isc-fs/IFS09-TE/hardware/docs/images/pcb_layout_2d.png

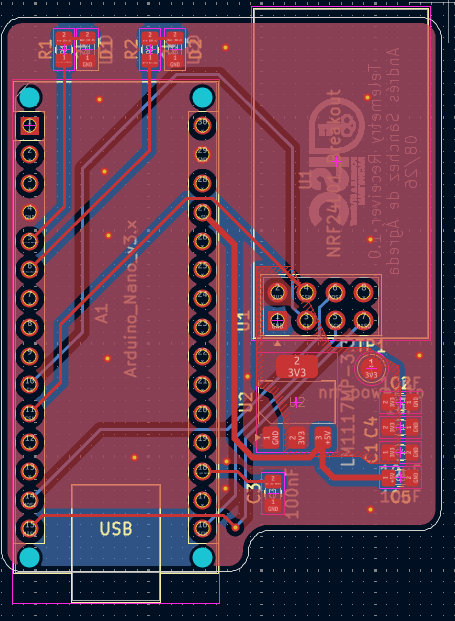
hardware/docs/images/pcb_layout_2d.png
