isc-fs/IFS09-TE/hardware/docs/images/pcb_render_3d.png

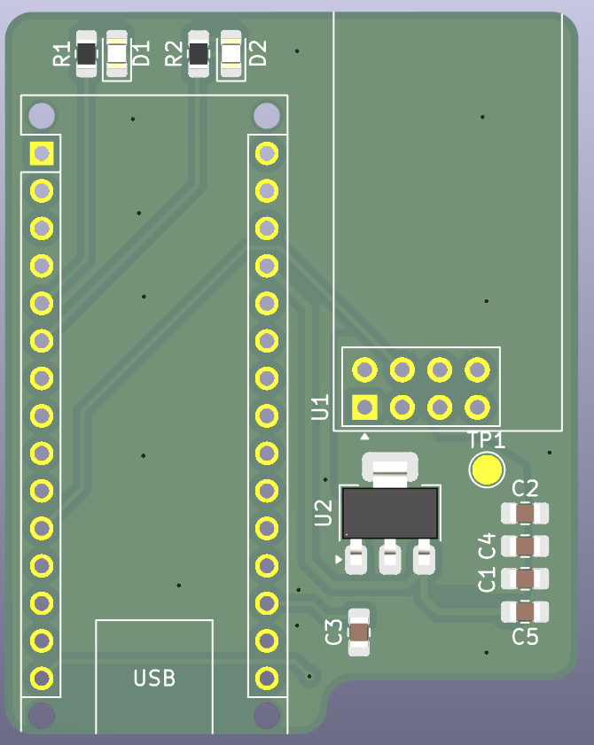
hardware/docs/images/pcb_render_3d.png
