isc-fs/IFS09-TE/hardware/docs/images/rf_nano_pinout.png

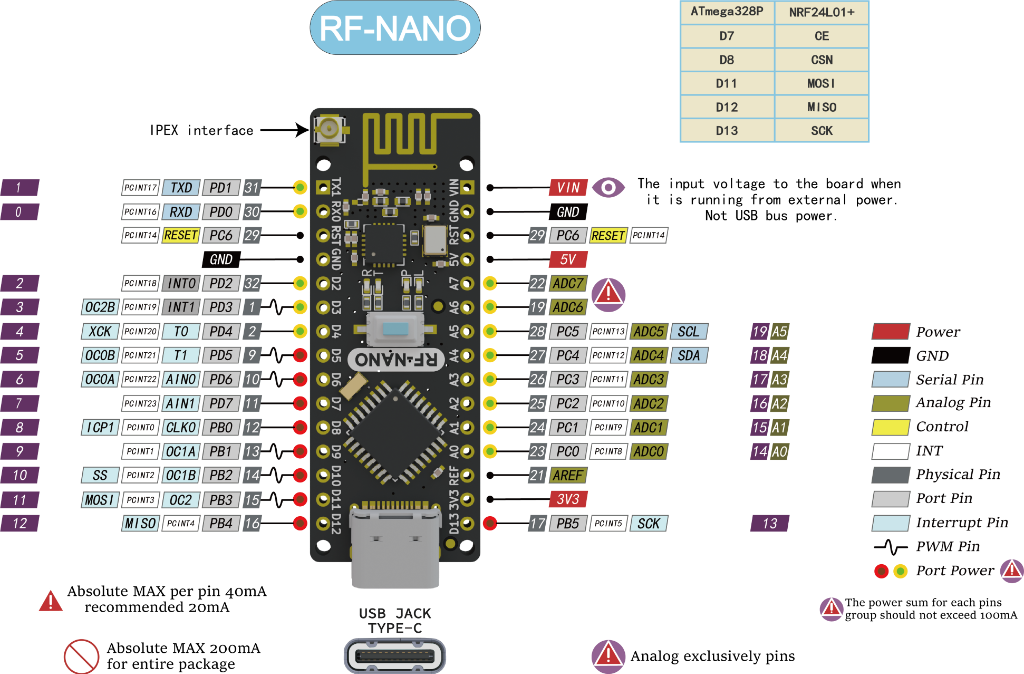
hardware/docs/images/rf_nano_pinout.png
