isc-fs/IFS09-TE/hardware/docs/images/schematic_v2.png

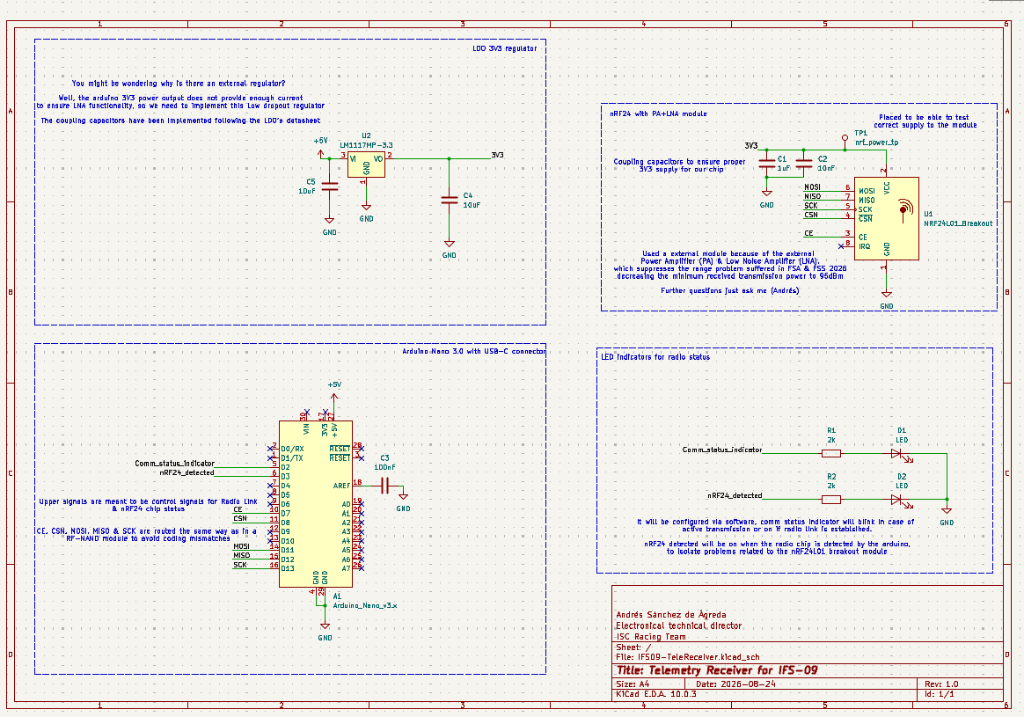
hardware/docs/images/schematic_v2.png
