isc-fs/IFS09-TE/isc_realtime_26/ISC_Telemetry_Guide.docx

ISC Telemetry Operational Guide

Hardware Setup, ISCmetrics Suite & Marple Cloud Data Platform

1. Physical Hardware Setup

1.1 Car Side (Transmitter / ECU)

• Antenna Positioning: Mount vertically on the roll hoop or shark fin with an insulating spacer. Maintain at least 3.5 cm (λ/4) clearance from carbon fiber panels to avoid signal absorption.
• RF Cabling: Use low-loss RG-316 or RG-142 coaxial cable with SMA connectors (< 50 cm). Route away from high-voltage (HV) lines and inverter phase cables.
• Decoupling Capacitor: High-power PA modules (e.g. E01-ML01DP5) draw up to 150 mA peak during transmit bursts. Solder a 10–100 µF electrolytic in parallel with a 100 nF ceramic capacitor directly across the module's VCC (3.3V) and GND pins.

1.2 Pitwall Side (USB Receiver Ground Station)

• Hardware: Arduino Nano / USB dongle connected to nRF24L01+ + PA/LNA module over SPI, communicating via USB-Serial at 115200 baud.
• Mast Elevation: Mount the high-gain antenna (+9 to +14 dBi) on a tripod mast 2.5 m to 3.5 m above ground to ensure line-of-sight and clear the first Fresnel zone above barriers and team personnel.

2. Installing & Running ISCmetrics

ISCmetrics is the official Formula Student telemetry desktop application developed for real-time monitoring, state machine diagnostics, and CSV logging.
• GitHub Repository: https://github.com/MrAndy5/ISCmetrics
• Latest Releases (Executable): https://github.com/MrAndy5/ISCmetrics/releases/latest

2.1 Installation from Source

git clone https://github.com/MrAndy5/ISCmetrics.git
cd ISCmetrics
python -m venv venv
.\venv\Scripts\Activate.ps1
pip install PyQt5 matplotlib pyserial numpy pandas marple requests python-can
python ui.py

2.2 Cloud Upload Authentication

★ MARPLE CLOUD UPLOAD PASSWORD
To enable cloud uploads in the Settings dialog, enter the password:
Password: ISC_telemetry_2026

Steps: Settings (Gear Icon) -> Check 'Upload to Marple Data (cloud)' -> Enter password -> Save.

2.3 Live Session Workflow

1. Select the Serial COM Port for the receiver dongle in the top bar.
2. Click CONNECT to begin live streaming (Inverter FSM, DC Bus, AMS module voltages & temps, APPS pedals, Brake pressure, Link health).
3. Click DISCONNECT when the run completes. The session CSV is saved under logs/ and automatically uploaded to Marple in the background.

3. Marple Data: Cloud Uploads & Analysis

• Default API Token: mdb_Le69BDaNdgn1SJ4DqWX6N6btH-a8Dx8Ou96aBbLA4v8
• Destination Stream: ISC_Telemetry
• Local Override: Place MARPLE_API_TOKEN=your_token in a .env file in the workspace.

3.1 Post-Race Data Fusion (SD Card Merge)

1. Open Tools -> Post-Race Analysis in ISCmetrics.
2. Select the recorded Session CSV.
3. Select the car's SD-card GPS Log (.nmea) and set the UTC timezone offset.
4. Select the AMS Temperatures Log (95 cells per-module data).
5. Click Merge & Push to Marple. The synchronized complete dataset is uploaded instantly.

3.2 Recommended Marple Derived Channels

Channel Name | Formula / Expression | Purpose / Threshold Alert
ams_max_cell_mv | MAX(vmax_mod0, vmax_mod1, vmax_mod2, vmax_mod3, vmax_mod4) | Overvoltage alert (> 4200 mV)
v_cell_min_mV | v_cell_min_mV (Raw mV) | Undervoltage alert (< 3000 mV)
ams_max_temp_c | MAX(tmax_mod0, tmax_mod1, tmax_mod2, tmax_mod3, tmax_mod4) | Thermal ceiling alert (> 55°C)
current_A | corriente_accu * 0.1 | Tractive pack current in Amperes
seq_jump | seq - PREV(seq) | Radio packet loss alarm (seq_jump > 1)

4. RF Range & PA/LNA Optimization

• PA + LNA Front-End: Using +20 dBm (100 mW) TX power with a +10 dB LNA receiver provides a +35 dB to +42 dB link budget improvement over base nRF24 modules.
• RF Channel: Set to Channel 76 or higher (2476 MHz+) to avoid trackside 2.4 GHz WiFi interference.
• 250 kbps Mode: Configuring 250 kbps on-air datarate increases receiver sensitivity to -94 dBm (adding +9 dB link margin).

5. Trackside Quick-Start Checklist

1. PLUG IN: Connect Arduino USB receiver dongle to laptop.
2. ELEVATE: Mount pit antenna on tripod mast (2.5m+ height).
3. CLONE/RUN: Clone https://github.com/MrAndy5/ISCmetrics.git & run 'python ui.py'.
4. UNLOCK CLOUD: Settings -> [X] Upload to Marple -> Enter: ISC_telemetry_2026
5. CONNECT: Select COM Port -> Click CONNECT.
6. POST-RACE: Tools -> Post-Race Analysis -> Merge SD GPS/AMS -> Upload to Marple.
