isc-fs/IFS09-TE/hardware/Schematics-1.0.pdf

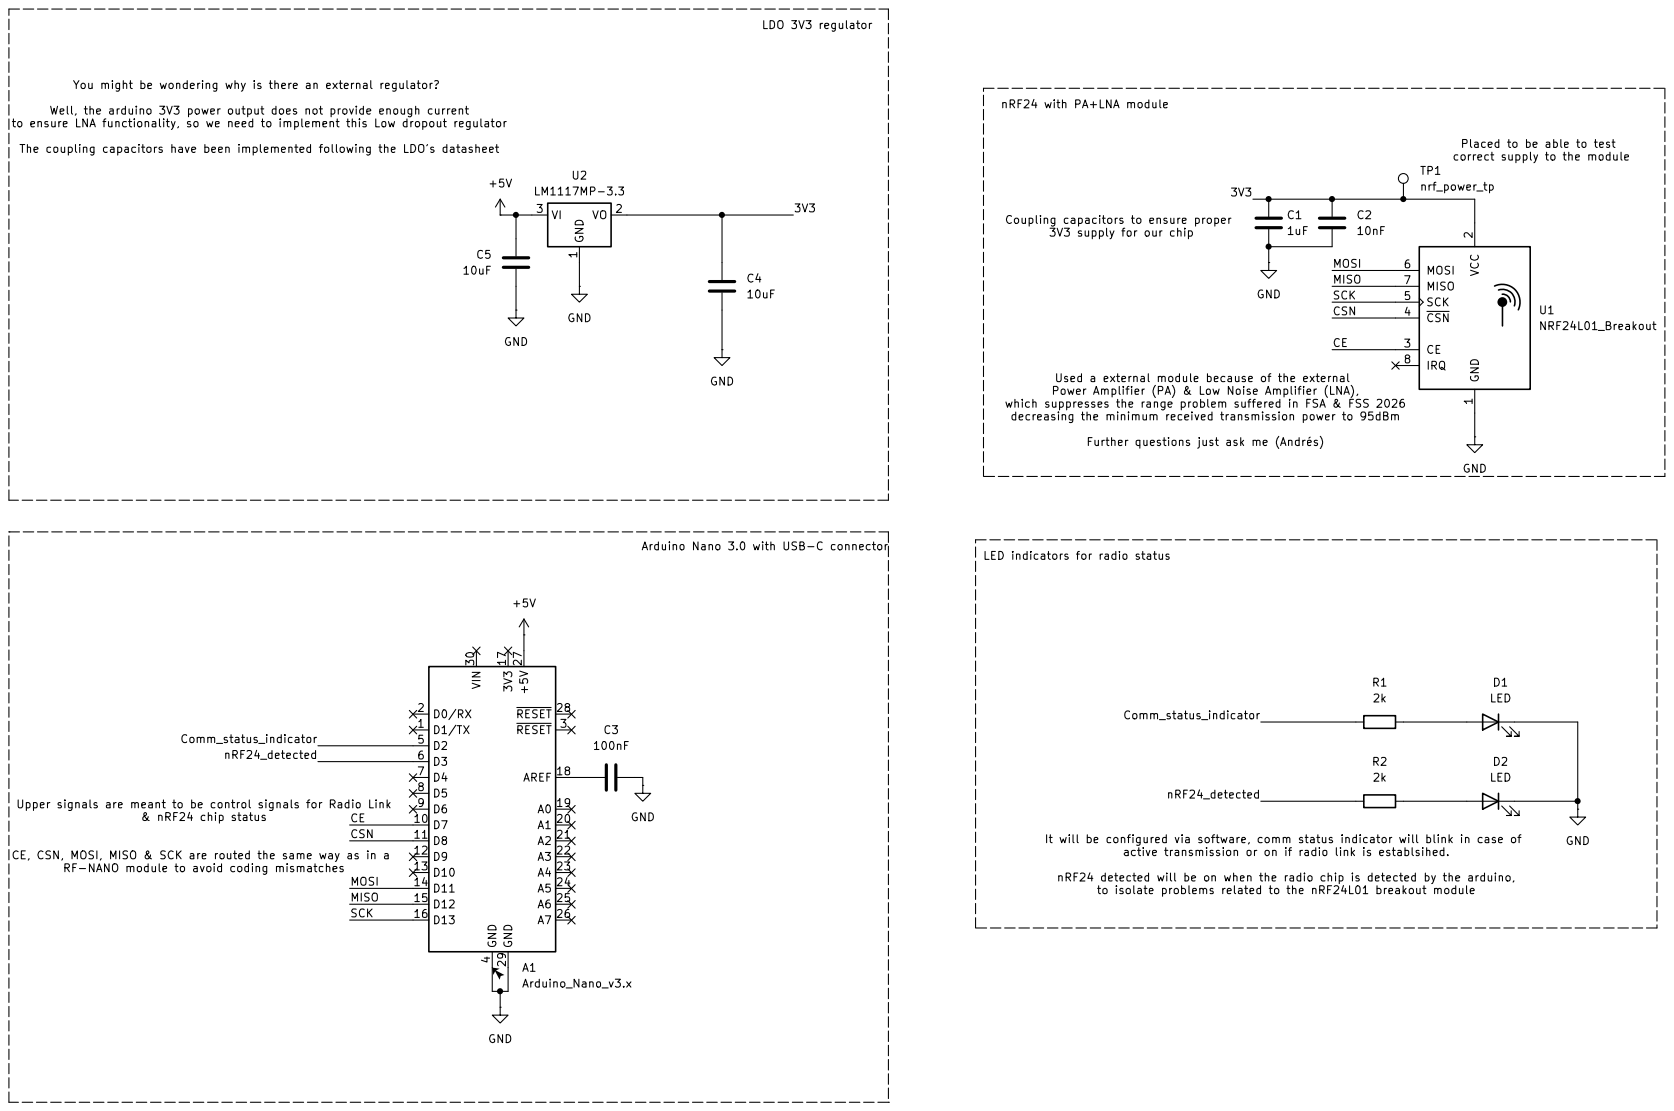
[picture p11: page 1]
