isc-fs/IFS09-TE/hardware/Schematics-2.0.pdf

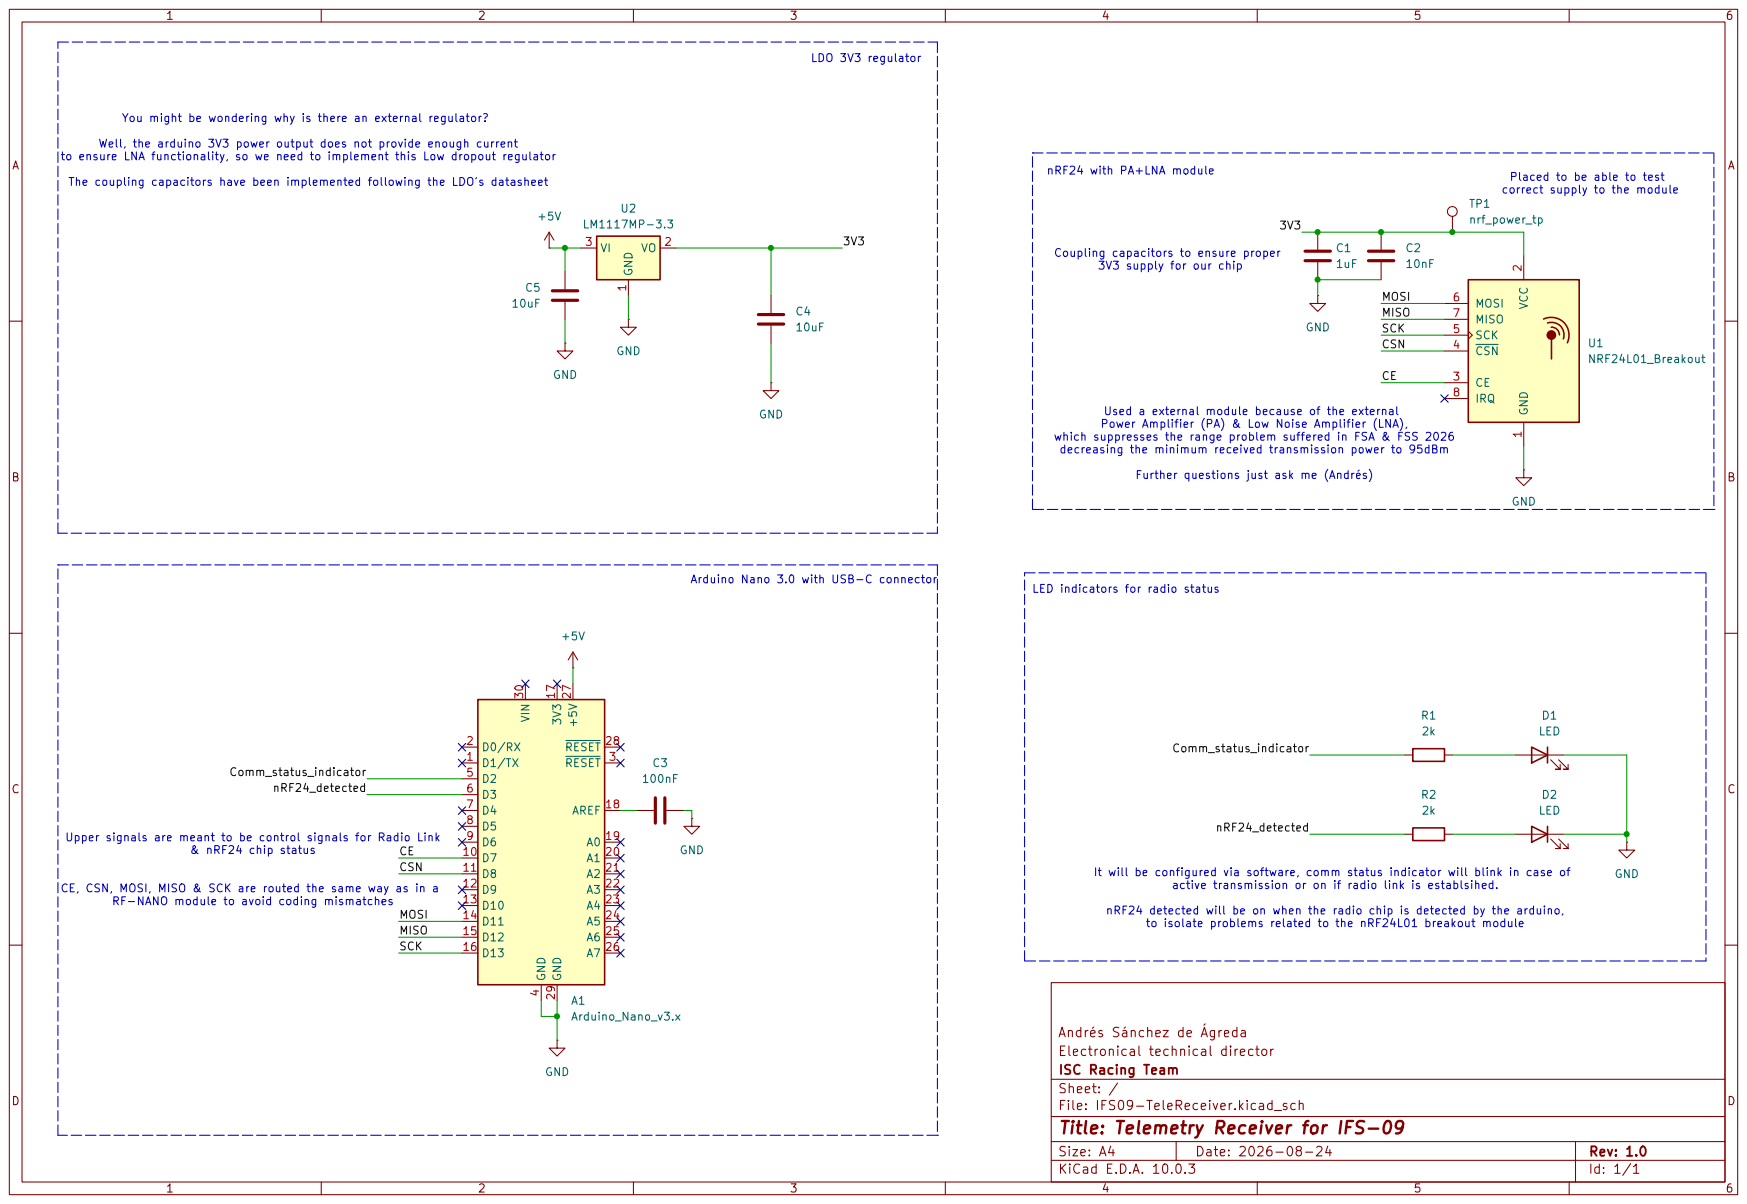
[picture p12: page 1]
