isc-fs/IFS09-TE/hardware/IFS09-TeleReceiver/IFS09-TeleReceiver.kicad_pcb

## KiCad design hardware/IFS09-TeleReceiver/IFS09-TeleReceiver.kicad_pcb (2026-09-07)

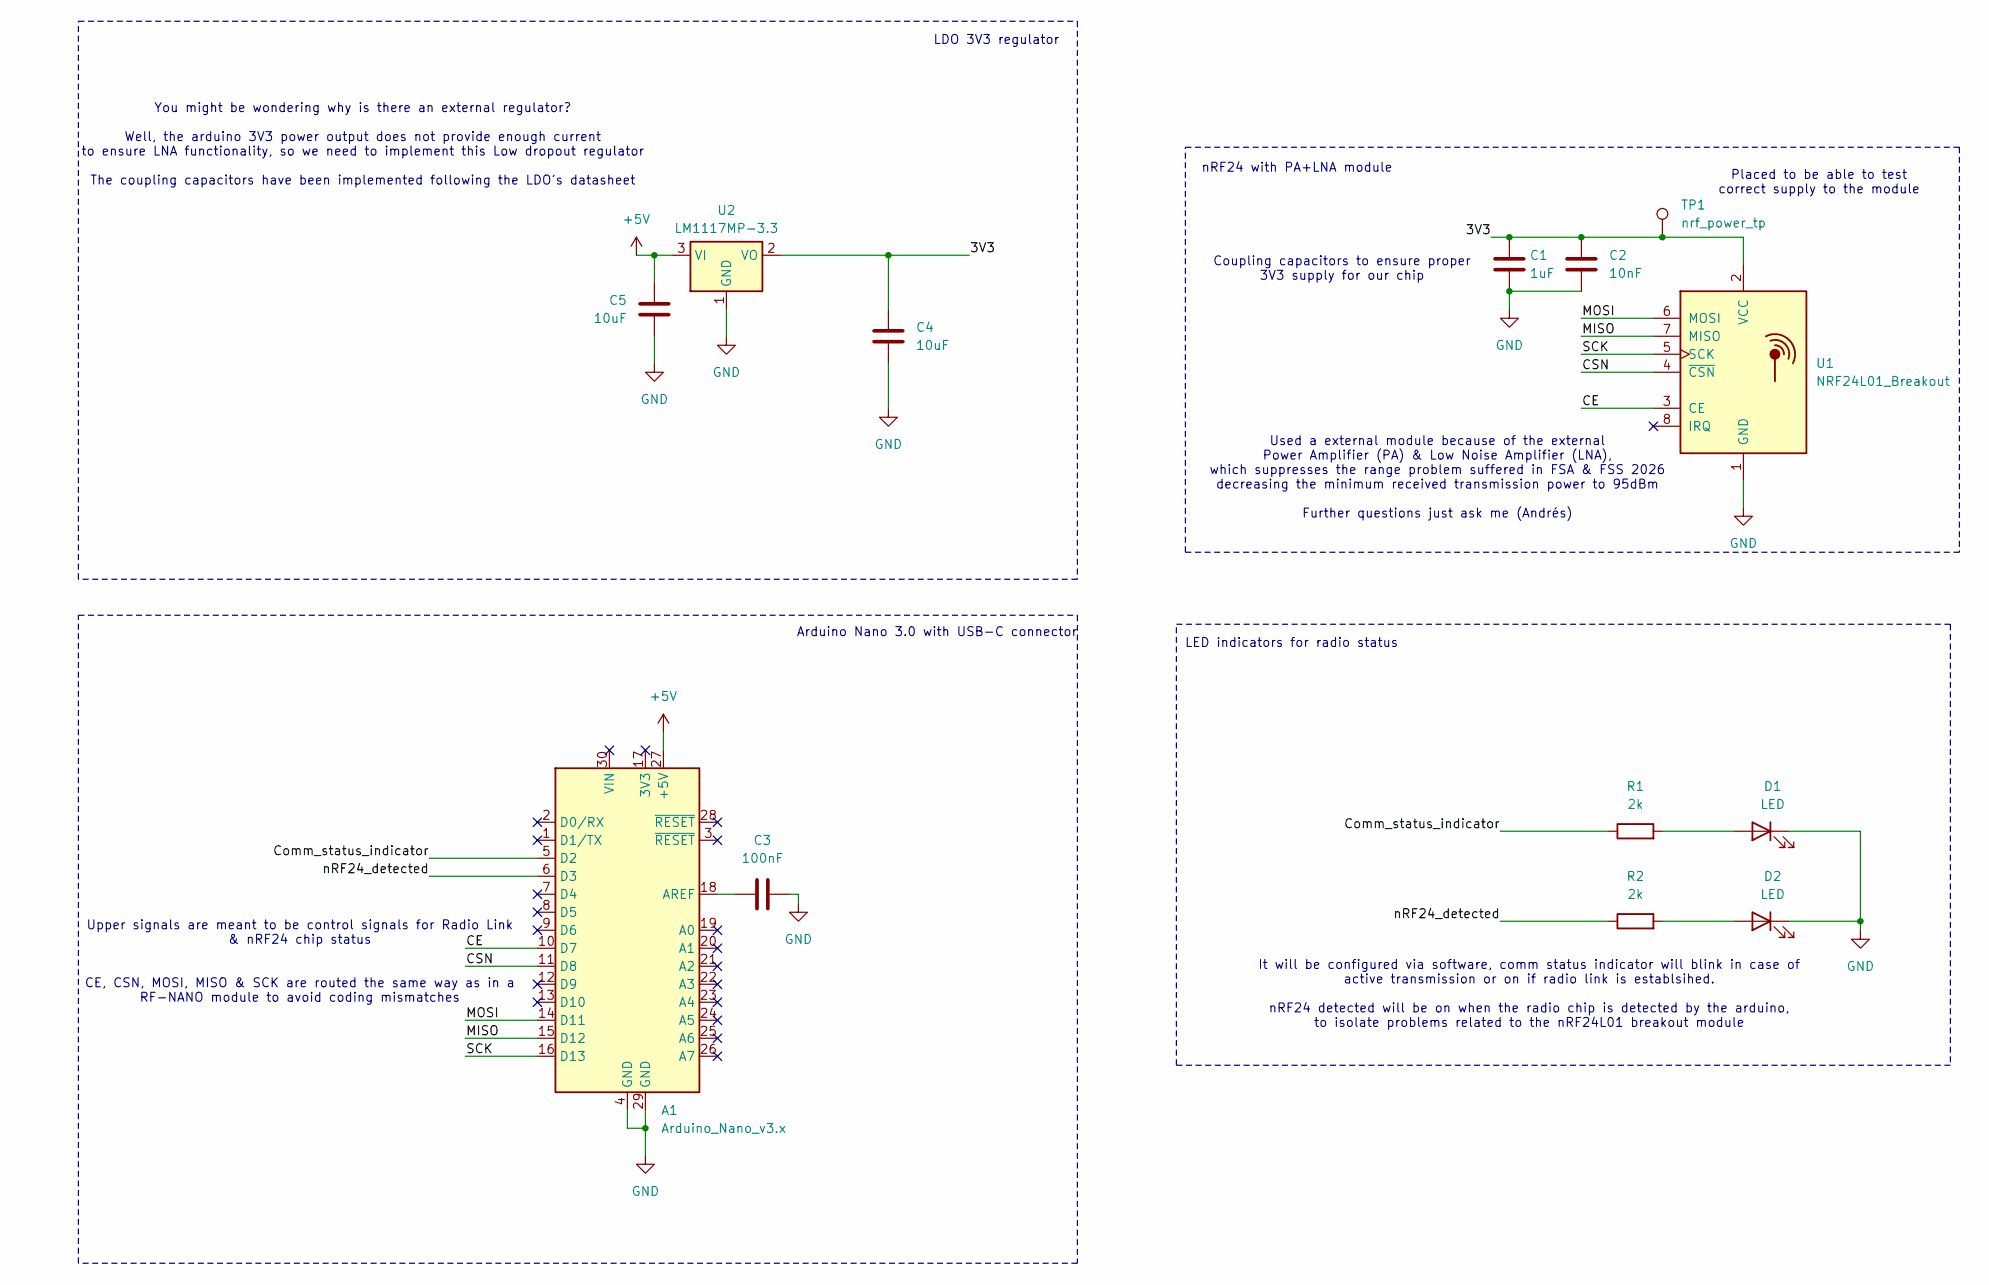
[picture p13: schematic IFS09-TeleReceiver.kicad_sch, Telemetry Receiver for IFS-09]

Parts:
A1: Arduino_Nano_v3.x; Arduino_Nano_WithMountingHoles
C1: 1uF; C_0805_2012Metric_Pad1.18x1.45mm_HandSolder
C2: 10nF; C_0805_2012Metric_Pad1.18x1.45mm_HandSolder
C3: 100nF; C_0805_2012Metric_Pad1.18x1.45mm_HandSolder
C4, C5: 10uF; C_0805_2012Metric_Pad1.18x1.45mm_HandSolder
D1, D2: LED; LED_0805_2012Metric_Pad1.15x1.40mm_HandSolder
R1, R2: 2k; R_0805_2012Metric_Pad1.20x1.40mm_HandSolder
TP1: nrf_power_tp; TestPoint_Pad_D2.0mm
U1: NRF24L01_Breakout; nRF24L01_Breakout
U2: LM1117MP-3.3; SOT-223-3_TabPin2

Connections:
+5V: A1.27 (+5V), C5.1, U2.3 (VI)
/3V3: C1.2, C2.2, C4.1, TP1.1 (1_1), U1.2 (VCC), U2.2 (VO)
/CE: A1.10 (D7), U1.3 (CE)
/CSN: A1.11 (D8), U1.4 (~CSN)
/Comm_status_indicator: A1.5 (D2), R1.1
/MISO: A1.15 (D12), U1.7 (MISO)
/MOSI: A1.14 (D11), U1.6 (MOSI)
/SCK: A1.16 (D13), U1.5 (SCK)
/nRF24_detected: A1.6 (D3), R2.1
GND: A1.4 (GND), A1.29 (GND), C1.1, C2.1, C3.1, C4.2, C5.2, D1.1 (K), D2.1 (K), U1.1 (GND), U2.1 (GND)
unnamed: A1.18 (AREF), C3.2
unnamed: D1.2 (A), R1.2
unnamed: D2.2 (A), R2.2

Notes on the sheet:
You might be wondering why is there an external regulator? Well, the arduino 3V3 power output does not provide enough current to ensure LNA functionality, so we need to implement this Low dropout regulator The coupling capacitors have been implemented following the LDO's datasheet
LDO 3V3 regulator
nRF24 with PA+LNA module
LED indicators for radio status
It will be configured via software, comm status indicator will blink in case of active transmission or on if radio link is establsihed. nRF24 detected will be on when the radio chip is detected by the arduino, to isolate problems related to the nRF24L01 breakout module
Placed to be able to test correct supply to the module
Coupling capacitors to ensure proper 3V3 supply for our chip
Arduino Nano 3.0 with USB-C connector
Used a external module because of the external Power Amplifier (PA) & Low Noise Amplifier (LNA), which suppresses the range problem suffered in FSA & FSS 2026 decreasing the minimum received transmission power to 95dBm Further questions just ask me (Andrés)
Upper signals are meant to be control signals for Radio Link & nRF24 chip status CE, CSN, MOSI, MISO & SCK are routed the same way as in a RF-NANO module to avoid coding mismatches

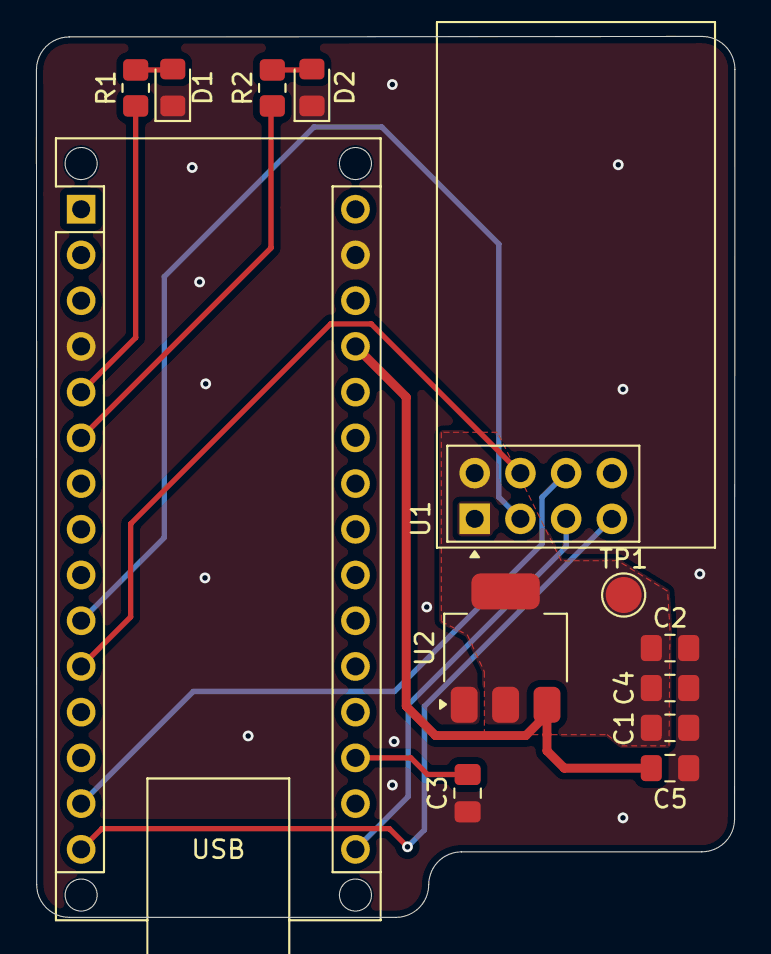
[picture p14: board IFS09-TeleReceiver.kicad_pcb from above]

Board: 2 copper layers, 38.8 x 48.9 mm, 13 parts (0 on the bottom side), 13 nets.
