isc-fs/IFS09-TE/isc_realtime_26/ui.py

"""
ISCmetrics v2 — ISC Formula Student Telemetry System
Developed by Andrés Sánchez de Ágreda © 2025/2026
F1 / Grafana dark-mode visualization — Fragmented Snapshot Protocol
"""

from __future__ import annotations
import sys
import math
import threading
import time
import logging
import subprocess
import hashlib
import webbrowser
try:
    import requests as _requests
    _REQUESTS_OK = True
except ImportError:
    _REQUESTS_OK = False

_CAN_OK = False
try:
    import can
    _CAN_OK = True
except ImportError:
    pass

import struct
import random
import zlib
import csv
import io
from collections import deque
from datetime import datetime
from pathlib import Path
from typing import Optional, Dict, List, Deque

import numpy as np
import matplotlib
matplotlib.use("Qt5Agg")

from PyQt5.QtCore import (
    QTimer, Qt, QMimeData, QObject, pyqtSignal, QPoint, QThread
)
from PyQt5.QtGui import (
    QFont, QPalette, QColor, QPixmap, QIcon,
    QPainter, QPen, QBrush, QLinearGradient, QDrag
)
from PyQt5.QtWidgets import (
    QApplication, QMainWindow, QVBoxLayout, QHBoxLayout, QGridLayout,
    QWidget, QLabel, QPushButton, QLineEdit, QComboBox, QTextEdit,
    QMessageBox, QTabWidget, QFrame, QGroupBox, QCheckBox,
    QListWidget, QListWidgetItem, QDialog, QSizePolicy, QInputDialog,
    QProgressBar, QTableWidget, QTableWidgetItem, QAbstractItemView, QHeaderView,
    QScrollArea
)
from matplotlib.backends.backend_qt5agg import FigureCanvasQTAgg as FigureCanvas
from matplotlib.figure import Figure
import matplotlib.pyplot as plt

import ISC_RTT_serial as rtt

# ── Optional demo module ──────────────────────────────────────────────────────
try:
    import ISC_RTT_demo as demo
    DEMO_AVAILABLE = True
except ImportError:
    DEMO_AVAILABLE = False

# ── Multi-log sync & Marple exporter engines ──────────────────────────────────
try:
    from core.sync import MultiLogSynchronizer, SyncSummary
    from core.marple_exporter import MarpleExportWorker, export_session_to_marple_async
    from ui.modals import PostMergeConfirmationModal, ManualMarpleExportDialog
    CORE_MODULES_OK = True
except ImportError:
    CORE_MODULES_OK = False

# ══════════════════════════════════════════════════════════════════════════════
#  VERSION  — patched automatically by GitHub Actions on each release tag
# ══════════════════════════════════════════════════════════════════════════════
APP_VERSION    = "2.10.0"
_RELEASES_URL  = "https://api.github.com/repos/MrAndy5/ISCmetrics/releases/latest"
_RELEASES_PAGE = "https://github.com/MrAndy5/ISCmetrics/releases/latest"

logger = logging.getLogger("ISC_RTT_USB")

# ── NxTech Inverter FSM State Machine ────────────────────────────────────────
# Source: NxTech Portal — Controller state machine section
# App_State_App / App_State_Req enumeration (both Tx and Rx use same values)
INVERTER_STATES_MAP = {
    1:  "INIT",               # Initialization state
    2:  "POST",               # Power-On Self Test
    3:  "STANDBY",            # Awaiting HV
    4:  "READY",              # HV detected, ready for active control
    5:  "CURRENT",            # Current control (active)
    6:  "TORQUE",             # Torque control (active)
    7:  "SPEED",              # Speed control (active)
    8:  "Placeholder",
    9:  "Placeholder",
    10: "FAULT_SOFT",         # Non-latched fault — reset via STANDBY request
    11: "FAULT_HARD",         # Latched fault — needs power cycle or SHUTDOWN request
    12: "DISCHARGE",          # Discharging DC-Link
    13: "SHUTDOWN",           # Shutting down (power saving)
    14: "OFF",                # LV is off
}
# Active control states (torque is being applied)
_INV_ACTIVE_STATES = {5, 6, 7}
# Short names for the live INV STATE card (number + name)
_STATE_SHORT_MAP = {
    0: "OFF",  1: "INIT",  2: "POST",   3: "AWAIT HV", 4: "HV RDY",
    5: "CURR", 6: "TORQUE",7: "SPEED", 10: "FLT SOFT",11: "FLT HARD",
   12: "DISCHG",13:"SLEEP",14: "LV OFF",
}

# ── ECU Control FSM States (ecu::CtrlState from control.hpp in IFS08-CE-ECU) ──
ECU_CTRL_STATE_MAP = {
    0: "WAIT_VDC",      # WaitInvVdcConfig (0x466)
    1: "PRECHARGE",     # Precharge (stream 0x100, wait for 0x020)
    2: "WAIT_START",    # WaitStartBrake (wait start button + brake)
    3: "R2D_BUZZER",    # R2dDelay (RTDS buzzer sounding)
    4: "WAIT_STANDBY",  # WaitInvStandby (command ready, wait for inverter)
    5: "ACTIVE",        # Active (runtime torque)
    6: "AMS_ERROR",     # AmsError (inhibited)
}

# ── AMS FSM States (IFS08-CE-AMS) ─────────────────────────────────────────────
AMS_FSM_STATE_MAP = {
    0: "STANDBY",
    1: "PRECHARGE",
    2: "ARMED",
    3: "R2D",
    4: "CHARGE",
    5: "ERROR",
}


# ── NxTech DEM Diagnostic Codes (L3 — DEM_Code) ─────────────────────────────
# Source: NxTech Portal — Diagnostics section, L3 table
# inv_error = DEM_Code from EMC_TX_STATE_2 (0x461).
# The DEM cycles through all registered errors/warnings; 0 = everything OK.
INVERTER_ERRORS_MAP = {
    0:  "No Fault",
    1:  "Lost msg: setpoint not received",
    2:  "DCBus Undervoltage",
    3:  "PwrStg Overtemperature",
    4:  "PwrStg Temp Degradation",
    5:  "EMCtrl Fault (see PwrStg_BitState / EMCtrl_FOC_BitState)",
    6:  "Task Overrun",
    7:  "CAN1 BusOff",
    8:  "EMachine Overtemperature",
    9:  "Phase Current Out-of-Range",
    10: "Power Stage Temp Out-of-Range",
    11: "DC Bus Out-of-Range",
    12: "DP Overtemp",
    13: "DRV Overtemp",
    14: "Aux Supply Undervoltage",
    15: "Aux Supply Overvoltage",
    16: "Overspeed",
    17: "Speed Degrade",
    18: "EMachine Temp Degrade",
    19: "Bad Current Offset",
    20: "AbsEnc Error 1",
    21: "Ext Temp 1 Out-of-Range",     # Sensor 1 disconnected / inadequate wiring
    22: "Ext Temp 2 Out-of-Range",     # Sensor 2 (KTY81-210 motor winding) out of range
    23: "PMIC Not Ready",
    24: "E2E CRC Fault (setpoint)",
    25: "E2E CNT Fault (setpoint)",
    26: "Invalid Calibration",
    27: "E2E CRC Fault (state)",
    28: "E2E CNT Fault (state)",
    29: "Crosscheck Fault",
    30: "Crosscheck Torque",
    31: "Wrong Member",
    32: "Hardware Supervisor Fault",   # KL30/31 supply inadequate
    33: "KL30 Undervoltage",
    34: "KL30 Overvoltage",
    35: "Lost Message (setpoint)",
    36: "Torque Not Coherent",
    37: "LV External Sensor Supply Fault",  # 5V supply shorted or KL30/31 inadequate
}

# ── DEM Safe State reference ──────────────────────────────────────────────────
INVERTER_ERRORS_SAFESTATE = {
    1: "Freewheeling", 2: "Freewheeling", 3: "Freewheeling", 4: "Degrade",
    5: "Freewheeling", 6: "Freewheeling", 7: "None", 8: "Freewheeling",
    9: "Freewheeling", 10: "Freewheeling", 11: "Freewheeling", 12: "Freewheeling",
    13: "Freewheeling", 14: "Freewheeling", 15: "None", 16: "Freewheeling",
    17: "Degrade", 18: "Degrade", 19: "Freewheeling", 20: "Freewheeling",
    21: "None", 22: "None", 23: "Freewheeling", 24: "Freewheeling",
    25: "Freewheeling", 26: "Freewheeling", 27: "Freewheeling", 28: "Freewheeling",
    29: "Freewheeling", 30: "Freewheeling", 31: "Freewheeling", 32: "Freewheeling",
    33: "Freewheeling", 34: "Freewheeling", 35: "Freewheeling", 36: "Freewheeling",
    37: "Freewheeling",
}

def decode_inverter_state(state_code: int) -> str:
    name = INVERTER_STATES_MAP.get(state_code, f"State {state_code}")
    # Official descriptions per NxTech documentation
    descs = {
        1: "Init",
        2: "Power-On Self Test",
        3: "Awaiting HV",
        4: "HV Ready",
        5: "Current Active",
        6: "Torque Active",
        7: "Speed Active",
        10: "Non-latched Fault",
        11: "Latched Fault / Shutdown",
        12: "Discharging DC-Link",
        13: "Power Saving Sleep",
        14: "LV Off",
    }
    desc = descs.get(state_code)
    return f"{name} ({desc})" if desc else name

def decode_inverter_errors(error_code: int, state_code: int = 0) -> list:
    """Decode DEM_Code from EMC_TX_STATE_2. Returns empty list when no fault."""
    if error_code == 0:
        return []
    desc = INVERTER_ERRORS_MAP.get(error_code, f"DEM Code {error_code} (Unknown)")
    safe = INVERTER_ERRORS_SAFESTATE.get(error_code, "")
    suffix = f" [{safe}]" if safe else ""
    fault_type = "SOFT" if state_code == 10 else "HARD" if state_code == 11 else "DEM"
    return [f"{fault_type}: {desc}{suffix}"]


# ══════════════════════════════════════════════════════════════════════════════
#  COLOUR SCHEME  (ISC Green / Grafana dark)
# ══════════════════════════════════════════════════════════════════════════════
ISC_GREEN   = '#008000'
F1_DARK_BG  = '#111111'
F1_MID_BG   = '#1a1a1a'
F1_PANEL_BG = '#222222'
F1_TEXT     = '#f1f5f9'          # Crisp high-contrast bright text
F1_MUTED    = '#94a3b8'          # Slate-400 for highly legible secondary labels
F1_ACCENT   = ISC_GREEN          # backward-compat alias
F1_WARNING  = '#f59e0b'          # Amber
F1_ERROR    = '#ef4444'          # Red
F1_BLUE     = '#38bdf8'          # Sky blue
F1_PURPLE   = '#a855f7'          # Purple


# ── Marple upload password (SHA-256 of 'ISC_telemetry_2026') ─────────────────
_MARPLE_PASSWORD_HASH = hashlib.sha256(b"ISC_telemetry_2026").hexdigest()

# Alert thresholds
ALERT_TEMP_C   = 40.0   # °C   — any module max temp above this
ALERT_VOLT_V   = 380    # V    — DC bus below this
ALERT_CELL_MV      = 3400   # mV   — per-module min cell voltage below this
ALERT_CELL_IMB_MV  = 100    # mV   — max cell imbalance (vmax-vmin) above this triggers alert

HISTORY_LEN  = 120    # rolling plot sample depth
ADC_MAX      = 4095   # 12-bit ADC full scale (pedal normalisation)
APPS1_MIN    = 2500   # raw ADC value at 0% depression
APPS1_MAX    = 3400   # raw ADC value at 100% depression
APPS2_MIN    = 2330   # raw ADC value at 0% depression
APPS2_MAX    = 3040   # raw ADC value at 100% depression
BRK_MIN      = 582    # brake ADC resting floor (reads ~580-584 at rest, hardcoded default)
BRK_MAX      = ADC_MAX  # brake ADC at full depression (overridden by calibration wizard)
RPM_MAX      = 6000

# ── Sony VTC6 95s6p — SoC estimation ────────────────────────────────────────
# Pack: 95s series × 6p parallel = 570 cells total
# Capacity: 6 × 3.0 Ah = 18 Ah
# Voltage range: 400 V (100% SOC) — 280 V (0% / cutoff as specified)
# Usable energy: 18 Ah × avg(400+280)/2 = 18 × 340 = 6 120 Wh
#
# SOC is calculated from DC Bus Voltage as primary source (always available
# even when cell-level sensors are not decoded correctly).
# OCV cell table is kept as secondary fine-grained source when cell mV is valid.

_SOC_V_FULL   = 400.0   # V — 100 % SoC
_SOC_V_CUTOFF = 280.0   # V — 0 % SoC (accumulator cutoff)
_PACK_AH      = 18.0    # Ah  (6p × 3.0 Ah VTC6)
_PACK_WH      = _PACK_AH * (_SOC_V_FULL + _SOC_V_CUTOFF) / 2.0  # ≈ 6 120 Wh

# Fine-grained OCV table for cell-level fallback (per-cell volts vs SoC)
_VTC6_OCV_TABLE = [
    (1.000, 4.211), (0.950, 4.150), (0.900, 4.100), (0.800, 4.020),
    (0.700, 3.940), (0.600, 3.870), (0.500, 3.800), (0.400, 3.740),
    (0.300, 3.680), (0.200, 3.600), (0.100, 3.500), (0.050, 3.400),
    (0.000, 2.947),  # 280 V / 95 cells
]

def soc_from_voltage(bus_v: float, cell_mv: float = 0.0,
                     current_a: float = 0.0) -> float:
    """
    Estimate SoC (0–100 %) for the 95s6p Sony VTC6 accumulator.

    Priority:
      1. DC Bus Voltage (inv_dc_bus_V) — always available, linear between
         280 V (0 %) and 400 V (100 %) as specified.
      2. Per-cell mV (v_cell_min_mV) — finer resolution via OCV table when
         the cell sensor is valid (> 2 500 mV, < 4 500 mV per cell).
         IR compensation applied: OCV = V_cell + I × 0.35 mV/A.

    Returns SoC as a float in [0.0, 100.0].
    """
    # ── Primary: DC Bus Voltage ───────────────────────────────────────────
    if bus_v and bus_v > _SOC_V_CUTOFF * 0.5:   # sanity: > 140 V
        soc_bus = (bus_v - _SOC_V_CUTOFF) / (_SOC_V_FULL - _SOC_V_CUTOFF) * 100.0
        soc_bus = max(0.0, min(100.0, soc_bus))

        # ── Secondary: refine with cell OCV if cell sensor is valid ──────
        if cell_mv and 2500 < cell_mv < 4500:
            # Rectify current magnitude for IR drop (ignore negative noise/polarity flip)
            curr_eff = abs(float(current_a))
            ir_drop_mv = curr_eff * 0.35
            ocv_v = (cell_mv + ir_drop_mv) / 1000.0
            soc_cell = None
            for i in range(len(_VTC6_OCV_TABLE) - 1):
                soc_hi, v_hi = _VTC6_OCV_TABLE[i]
                soc_lo, v_lo = _VTC6_OCV_TABLE[i + 1]
                if v_lo <= ocv_v <= v_hi:
                    frac = (ocv_v - v_lo) / (v_hi - v_lo) if v_hi != v_lo else 0.0
                    soc_cell = (soc_lo + frac * (soc_hi - soc_lo)) * 100.0
                    break
            if soc_cell is None:
                soc_cell = 100.0 if ocv_v >= _VTC6_OCV_TABLE[0][1] else 0.0
            soc_cell = max(0.0, min(100.0, soc_cell))
            # Blend: 60% cell OCV (finer) + 40% bus voltage (robustness)
            return round(0.6 * soc_cell + 0.4 * soc_bus, 1)

        return round(soc_bus, 1)

    # ── Fallback: cell-only if bus voltage missing ────────────────────────
    if cell_mv and 2500 < cell_mv < 4500:
        ir_drop_mv = max(0.0, float(current_a)) * 0.35
        ocv_v = (cell_mv + ir_drop_mv) / 1000.0
        for i in range(len(_VTC6_OCV_TABLE) - 1):
            soc_hi, v_hi = _VTC6_OCV_TABLE[i]
            soc_lo, v_lo = _VTC6_OCV_TABLE[i + 1]
            if v_lo <= ocv_v <= v_hi:
                frac = (ocv_v - v_lo) / (v_hi - v_lo) if v_hi != v_lo else 0.0
                return round((soc_lo + frac * (soc_hi - soc_lo)) * 100.0, 1)
        return 100.0 if ocv_v >= _VTC6_OCV_TABLE[0][1] else 0.0

    return 0.0  # no valid source


# Keep old name as alias so any remaining call sites still work
def soc_from_cell_mv(cell_mv: float, current_a: float = 0.0) -> float:
    return soc_from_voltage(0.0, cell_mv, current_a)

# ── Predictive Analytics Engine ──────────────────────────────────────────────
class PredictiveAnalyticsEngine:
    """
    Real-time predictive telemetry analytics engine for Formula Student:
    1. Driver Efficiency Index (Wh/km & Wh/min)
    2. Thermal Derating & Overtemp Predictor (dT/dt °C/min & time to 90°C trip)
    3. Battery Health & Internal Resistance Estimator (mΩ)
    4. Adaptive Driver Pace & Strategy Advisor (Recommended Torque % for 22min Endurance)
    """
    def __init__(self, target_endurance_min: float = 22.0):
        self.target_endurance_min = target_endurance_min
        self._t_hist = deque(maxlen=300)      # 30s at 10Hz
        self._tm2_hist = deque(maxlen=300)    # 30s at 10Hz
        self._prev_iaccu = 0.0
        self._prev_vbus = 0.0
        self._r_int_samples = deque(maxlen=50) # rolling R_int estimates
        self.r_int_mOhm = 285.0                # default baseline ~285 mΩ (95s6p VTC6)
        # Integrated Wh counter
        self._wh_used   = 0.0
        self._prev_time = None

    def reset(self):
        self._t_hist.clear()
        self._tm2_hist.clear()
        self._r_int_samples.clear()
        self._prev_iaccu = 0.0
        self._prev_vbus = 0.0
        self._wh_used   = 0.0
        self._prev_time = None

    def compute(self, s: dict, soc_vtc6: float, i_eff: float) -> dict:
        vbus = float(s.get('inv_dc_bus_V', 0))
        iaccu = float(s.get('corriente_accu', 0))
        istate = int(s.get('inv_state', 0))
        tq_req = float(s.get('torque_pct', 0))
        if iaccu < 0 and (istate == 6 or s.get('inv_rpm', 0) > 100 or tq_req > 2):
            iaccu = abs(iaccu)
        spd = float(s.get('inv_speed_actual', 0))
        tm2 = float(s.get('inv_temp_motor2', s.get('inv_temp_pwrstg', 0)))
        elapsed = float(s.get('time_elapsed_s', 0))

        # 1. Driver Efficiency Index (Wh/min & Wh/km)
        pwr_w = i_eff * vbus if (vbus > 140) else 0.0
        pwr_kw = pwr_w / 1000.0
        eff_wh_min = (pwr_w / 60.0)
        eff_wh_km = (pwr_kw / spd * 1000.0) if spd > 5.0 else 0.0

        # 2. Thermal dT/dt & Overtemp Predictor
        self._t_hist.append(elapsed)
        self._tm2_hist.append(tm2)
        thermal_dt_dt = 0.0
        thermal_t_overtemp = 999.0

        if len(self._t_hist) > 20:
            dt_s = self._t_hist[-1] - self._t_hist[0]
            dtm2 = self._tm2_hist[-1] - self._tm2_hist[0]
            if dt_s > 2.0:
                thermal_dt_dt = round((dtm2 / dt_s) * 60.0, 1)  # °C / min
                if thermal_dt_dt > 0.5 and tm2 < 90.0:
                    thermal_t_overtemp = round((90.0 - tm2) / thermal_dt_dt, 1)

        # 3. Battery Health & Internal Resistance R_int (mΩ)
        if self._prev_iaccu != 0.0 and self._prev_vbus > 140 and vbus > 140:
            di = iaccu - self._prev_iaccu
            dv = vbus - self._prev_vbus
            # High-current step transition detection (di > 10A and dv < -1V)
            if di > 10.0 and dv < -1.0:
                r_est = (abs(dv) / di) * 1000.0  # mΩ
                if 50.0 <= r_est <= 800.0:
                    self._r_int_samples.append(r_est)
                    self.r_int_mOhm = round(sum(self._r_int_samples) / len(self._r_int_samples), 1)

        self._prev_iaccu = iaccu
        self._prev_vbus = vbus

        # 4. Adaptive Driver Pace & Strategy Advisor
        wh_rem = _PACK_WH * (soc_vtc6 / 100.0)
        t_target_h = self.target_endurance_min / 60.0
        pwr_target_kw = wh_rem / t_target_h / 1000.0  # kW

        if pwr_kw > 0.5:
            rec_torque = min(100.0, round(tq_req * (pwr_target_kw / max(0.5, pwr_kw)), 0))
        else:
            rec_torque = 100.0

        # ── Integrated Wh counter ─────────────────────────────────────────────
        # corriente_accu polarity: positive = discharge (or abs if already corrected)
        import time as _time
        _now = _time.monotonic()
        if self._prev_time is not None and vbus > 140 and iaccu > 0:
            dt_h = (_now - self._prev_time) / 3600.0
            self._wh_used += (iaccu * vbus) * dt_h
        self._prev_time = _now

        # ── Cell imbalance: max (vmax-vmin) across modules ─────────────────────
        vmin_arr = s.get('vmin_modulo', [])
        vmax_arr = s.get('vmax_modulo', [])
        cell_imbalance_mV = 0.0
        if vmin_arr and vmax_arr:
            for vm_lo, vm_hi in zip(vmin_arr, vmax_arr):
                if vm_hi > 0 and vm_lo > 0:
                    cell_imbalance_mV = max(cell_imbalance_mV, vm_hi - vm_lo)

        return {
            'eff_wh_min':          round(eff_wh_min, 1),
            'eff_wh_km':           round(eff_wh_km, 1),
            'thermal_dt_dt':       thermal_dt_dt,
            'thermal_t_overtemp':  thermal_t_overtemp,
            'batt_r_int':          self.r_int_mOhm,
            'strategy_pwr_target': round(pwr_target_kw, 2),
            'strategy_rec_torque': int(rec_torque),
            'session_wh_used':     round(self._wh_used, 2),
            'cell_imbalance_mV':   round(cell_imbalance_mV, 1),
        }

# ── All ECU signals available in the Customise tab ───────────────────────────
# Format: 'snapshot_key': ('Display Label', 'unit')
SNAPSHOT_CHANNELS: Dict[str, tuple] = {
    # ── Frame header ───────────────────────────────────────────────────────
    'tick_ms':              ('RTOS Tick',              'ms'),
    'seq':                  ('Snapshot Seq',           ''),
    # ── Driver inputs ──────────────────────────────────────────────────────
    'start_button':         ('Start Button',           '0/1'),
    'apps1_raw':            ('APPS Sensor A',          'ADC'),
    'apps2_raw':            ('APPS Sensor B',          'ADC'),
    'brake_raw':            ('Brake Pressure',         'ADC'),
    # ── Control FSM ───────────────────────────────────────────────────────
    'torque_pct':           ('Torque Request',         '%'),
    'ev_2_3':               ('EV 2/3 Flags',           ''),
    't11_8_9':              ('T.11 Interlock',         ''),
    'state':                ('Control FSM State',      ''),
    # ── Battery / AMS — pack level ─────────────────────────────────────────
    'ok_precharge':         ('Precharge OK',           '0/1'),
    'ams_fsm_state':        ('AMS FSM State',          ''),
    'v_cell_min_mV':        ('Min Cell Voltage',       'mV'),
    'soc':                  ('State of Charge',        '%'),
    # ── Battery / AMS — per-module min cell voltage ────────────────────────
    'vmin_modulo_0':        ('Vmin Module 0',          'mV'),
    'vmin_modulo_1':        ('Vmin Module 1',          'mV'),
    'vmin_modulo_2':        ('Vmin Module 2',          'mV'),
    'vmin_modulo_3':        ('Vmin Module 3',          'mV'),
    'vmin_modulo_4':        ('Vmin Module 4',          'mV'),
    # ── Battery / AMS — per-module max cell voltage ────────────────────────
    'vmax_modulo_0':        ('Vmax Module 0',          'mV'),
    'vmax_modulo_1':        ('Vmax Module 1',          'mV'),
    'vmax_modulo_2':        ('Vmax Module 2',          'mV'),
    'vmax_modulo_3':        ('Vmax Module 3',          'mV'),
    'vmax_modulo_4':        ('Vmax Module 4',          'mV'),
    # ── Battery / AMS — current & DC-DC ───────────────────────────────────
    'corriente_accu':       ('Pack Current',           'A'),
    'corriente_dcdc':       ('DC-DC Current',          'A'),
    'temp_dcdc':            ('DC-DC Temperature',      'ºC'),
    # ── Battery / AMS — per-module max temperature ─────────────────────────
    'tmax_modulo_0':        ('Tmax Module 0',          'ºC'),
    'tmax_modulo_1':        ('Tmax Module 1',          'ºC'),
    'tmax_modulo_2':        ('Tmax Module 2',          'ºC'),
    'tmax_modulo_3':        ('Tmax Module 3',          'ºC'),
    'tmax_modulo_4':        ('Tmax Module 4',          'ºC'),
    # ── Inverter status ───────────────────────────────────────────────────
    'inv_state':            ('Inverter State',         ''),
    'inv_vconfig_active':   ('Vconfig Active',         '0/1'),
    'inv_error':            ('Inverter Error (DEM)',   ''),
    'dem_code':             ('DEM Code',               ''),
    'emctrl_foc_bitstate':  ('EMCtrl FOC BitState',    'bitfield'),
    'est_time_remaining':   ('Est. Time Remaining',    'min'),
    # ── Inverter electrical ───────────────────────────────────────────────
    'inv_dc_bus_V':         ('DC Bus Voltage',         'V'),
    'inv_temp_motor1':      ('Ext Temp Sensor 1',      'ºC'),   # NTC on Sensor 1 input (disconnected = 255)
    'inv_temp_motor2':      ('Motor Temp (KTY)',       'ºC'),   # NTC on Sensor 2 input (KTY81-210 working sensor)
    'inv_temp_pwrstg':      ('Power Stage Temp (IGBT)', 'ºC'),   # Alias for Motor 2 / Sensor 2
    'inv_temp_board':       ('Inverter Board Temp',    'ºC'),
    # ── Motor speed & current ─────────────────────────────────────────────
    'inv_rpm':              ('Motor Speed',            'RPM'),
    'inv_speed_actual':     ('Vehicle Speed',          'km/h'),
    'inv_current_actual':   ('Motor Current',          'A'),
    # ── GPS live (from radio snapshot bytes 82-95) ─────────────────────────
    'gps_lat_deg':          ('GPS Latitude',           '°'),
    'gps_lon_deg':          ('GPS Longitude',          '°'),
    'gps_speed_kmh':        ('GPS Speed',              'km/h'),
    'gps_course_deg':       ('GPS Course',             '°'),
    'gps_sats':             ('GPS Satellites',         ''),
    'gps_has_fix':          ('GPS Fix',                '0/1'),
    # ── Predictive Analytics & Strategy ───────────────────────────────────
    'eff_wh_min':           ('Consumption Rate',       'Wh/min'),
    'eff_wh_km':            ('Driver Efficiency',      'Wh/km'),
    'thermal_dt_dt':        ('Motor Heating Rate',     'ºC/min'),
    'thermal_t_overtemp':   ('Est. Time to Overtemp',  'min'),
    'batt_r_int':           ('Pack Internal R',        'mΩ'),
    'strategy_pwr_target':  ('Endurance Target Power', 'kW'),
    'strategy_rec_torque':  ('Rec. Torque Limit',     '%'),
    'session_wh_used':      ('Session Energy Used',   'Wh'),
    'cell_imbalance_mV':    ('Max Cell Imbalance',    'mV'),
}

plt.style.use('dark_background')
plt.rcParams.update({
    'axes.facecolor':   F1_DARK_BG,
    'figure.facecolor': F1_DARK_BG,
    'text.color':       F1_TEXT,
    'axes.labelcolor':  F1_TEXT,
    'xtick.color':      F1_TEXT,
    'ytick.color':      F1_TEXT,
    'axes.edgecolor':   '#333333',
    'grid.color':       '#2a2a2a',
    'grid.alpha':       1.0,
})

current_settings: dict = {
    "port":       rtt.DEFAULT_PORT,
    "baud":       rtt.DEFAULT_BAUD,
    "use_influx": False,
    "debug":      rtt.DEBUG_ENABLE_DEFAULT,
    "demo_mode":  False,
    "enable_tts": True,
    "alert_temp_c":  ALERT_TEMP_C,
    "alert_volt_v":  ALERT_VOLT_V,
    "alert_cell_mv": ALERT_CELL_MV,
}


# ══════════════════════════════════════════════════════════════════════════════
#  SIGNAL EMITTER
# ══════════════════════════════════════════════════════════════════════════════
class Signaler(QObject):
    log_message = pyqtSignal(str)
    update_detected = pyqtSignal(str, str)    # version_tag, download_url
    download_progress = pyqtSignal(int)
    download_finished = pyqtSignal(str)     # filepath or error message starting with "ERR:"

signaler = Signaler()

class _QtLogHandler(logging.Handler):
    def __init__(self, sig: Signaler):
        super().__init__()
        self._sig = sig
    def emit(self, record):
        self._sig.log_message.emit(self.format(record))

logging.getLogger("ISC_RTT_USB").addHandler(_QtLogHandler(signaler))


# ══════════════════════════════════════════════════════════════════════════════
#  ALERT BANNER
# ══════════════════════════════════════════════════════════════════════════════
class AlertBanner(QFrame):
    """Flashing coloured strip shown when alert conditions are active."""
    def __init__(self, parent=None):
        super().__init__(parent)
        self._alerts: List[tuple] = []
        self._flash  = False
        self._base   = F1_ERROR
        self.setFixedHeight(28)
        self.setSizePolicy(QSizePolicy.Expanding, QSizePolicy.Fixed)
        self.hide()

        lay = QHBoxLayout(self)
        lay.setContentsMargins(10, 2, 10, 2)
        self._lbl = QLabel("")
        self._lbl.setAlignment(Qt.AlignCenter)
        lay.addWidget(self._lbl)

        self._ftimer = QTimer(self)
        self._ftimer.timeout.connect(self._toggle_flash)
        self._ftimer.start(450)

    def set_alerts(self, alerts: List[tuple]) -> None:
        self._alerts = alerts
        if not alerts:
            self.hide()
            return
        self.show()
        self._lbl.setText("   |   ".join(a[0] for a in alerts))
        self._lbl.setStyleSheet(f"color: {F1_DARK_BG}; font-size: 11px; font-weight: bold;")
        self._base = F1_ERROR if any(a[1] == 'critical' for a in alerts) else F1_WARNING

    def _toggle_flash(self):
        if not self._alerts:
            return
        self._flash = not self._flash
        dim = '#5a0000' if self._base == F1_ERROR else '#5a3e00'
        col = self._base if self._flash else dim
        self.setStyleSheet(f"QFrame {{ background: {col}; border-radius: 2px; }}")


# ══════════════════════════════════════════════════════════════════════════════
#  ROLLING PLOT CANVAS
# ══════════════════════════════════════════════════════════════════════════════
class MplCanvas(QWidget):
    """Grafana-style rolling time-series plot embedded in a QWidget."""
    def __init__(self, title: str = "", color: str = ISC_GREEN, parent=None):
        super().__init__(parent)
        self._color   = color
        self._history: Deque[float] = deque([0.0] * HISTORY_LEN, maxlen=HISTORY_LEN)

        fig = Figure(figsize=(4, 2), tight_layout=True)
        fig.patch.set_facecolor(F1_PANEL_BG)
        self._ax = fig.add_subplot(111)
        self._line, = self._ax.plot([], [], color=color, linewidth=1.4, antialiased=True)
        self._ax.set_facecolor(F1_DARK_BG)
        self._ax.set_title(title, color=color, fontsize=10, fontweight='bold', pad=3)
        self._ax.tick_params(labelsize=8.5, colors='#ffffff' if F1_TEXT == '#f1f5f9' else '#111111')
        self._ax.grid(True, color='#444444' if F1_TEXT == '#f1f5f9' else '#cccccc', alpha=0.35)
        for s in self._ax.spines.values():
            s.set_color('#555555' if F1_TEXT == '#f1f5f9' else '#aaaaaa')

        canvas = FigureCanvas(fig)
        lay = QVBoxLayout(self)
        lay.setContentsMargins(0, 0, 0, 0)
        lay.addWidget(canvas)
        self._canvas = canvas

    def update_plot(self, value: float) -> None:
        self._history.append(float(value))
        if not self.isVisible():
            return
        y = list(self._history)
        x = list(range(len(y)))
        self._line.set_data(x, y)
        for coll in self._ax.collections:
            coll.remove()
        self._ax.fill_between(x, y, alpha=0.10, color=self._color)
        lo, hi = min(y), max(y)
        mg = max((hi - lo) * 0.1, 1.0)
        self._ax.set_xlim(0, HISTORY_LEN)
        self._ax.set_ylim(lo - mg, hi + mg)
        self._canvas.draw_idle()


# ══════════════════════════════════════════════════════════════════════════════
#  METRIC CARD
# ══════════════════════════════════════════════════════════════════════════════
class MetricCard(QFrame):
    """Grafana-style metric tile: bold title, prominent 22px value, crisp unit, alert highlight."""
    def __init__(self, title: str, unit: str = "", color: str = ISC_GREEN, parent=None):
        super().__init__(parent)
        self._color   = color
        self._alerting = False
        self._cur_val  = "—"
        self._set_border(color)

        v = QVBoxLayout(self)
        v.setContentsMargins(10, 6, 10, 6)
        v.setSpacing(2)

        self._title = QLabel(title)
        self._title.setAlignment(Qt.AlignCenter)
        self._title.setStyleSheet(f"color:{color}; font-size:11px; font-weight:bold; background:transparent; border:none;")

        self._value = QLabel("—")
        self._value.setAlignment(Qt.AlignCenter)
        self._value.setStyleSheet(f"color:{F1_TEXT}; font-size:22px; font-weight:bold; background:transparent; border:none;")

        self._unit = QLabel(unit)
        self._unit.setAlignment(Qt.AlignCenter)
        self._unit.setStyleSheet(f"color:{F1_MUTED}; font-size:10.5px; font-weight:600; background:transparent; border:none;")

        v.addWidget(self._title)
        v.addWidget(self._value)
        v.addWidget(self._unit)

    def _set_border(self, color: str) -> None:
        self.setStyleSheet(f"QFrame {{ background:{F1_PANEL_BG}; border:1.5px solid {color}; border-radius:4px; }}")

    def set_value(self, text: str) -> None:
        if self._cur_val == text:
            return
        self._cur_val = text
        self._value.setText(text)

    def set_alert(self, active: bool) -> None:
        if active == self._alerting:
            return
        self._alerting = active
        col = F1_ERROR if active else self._color
        self.setStyleSheet(f"QFrame {{ background:{F1_PANEL_BG}; border:2px solid {col}; border-radius:4px; }}")
        self._title.setStyleSheet(f"color:{col}; font-size:11px; font-weight:bold; background:transparent; border:none;")


# ══════════════════════════════════════════════════════════════════════════════
#  INVERTER CONSTANTS & DIAGNOSTIC FLAGS (CAN 0x461, 0x466, 0x467, 0x468)
# ══════════════════════════════════════════════════════════════════════════════
INVERTER_STATE_MAP = {
    0: "0 (OFF)",
    1: "1 (INIT)",
    2: "2 (POST)",
    3: "3 (AWAIT HV)",
    4: "4 (HV READY)",
    5: "5 (CURRENT CTRL)",
    6: "6 (TORQUE ENABLE)",
    7: "7 (SPEED CTRL)",
    10: "10 (FAULT SOFT)",
    11: "11 (FAULT HARD)",
    12: "12 (DISCHARGE)",
    13: "13 (SHUTDOWN)",
    14: "14 (LV OFF)",
}

INVERTER_DEM_MAP = {
    0: "No Fault (Normal)",
    1: "Lost Setpoint Msg",
    2: "DC Bus Undervoltage",
    3: "Power Stage Overtemp",
    4: "PwrStg Temp Degrade",
    5: "EMCtrl Fault",
    6: "Task Overrun",
    7: "CAN BusOff",
    8: "EMachine Overtemp",
    9: "Phase Current OOR",
    10: "PwrStg Temp OOR",
    11: "DC Bus OOR",
    12: "DP Overtemp",
    13: "DRV Overtemp",
    14: "Aux Supply UV",
    15: "Aux Supply OV",
    16: "Overspeed",
    17: "Speed Degrade",
    18: "EMachine Temp Degrade",
    19: "Bad Current Offset",
    20: "Encoder Error",
    21: "Ext Temp 1 OOR",
    22: "Ext Temp 2 OOR",
    23: "PMIC Not Ready",
    26: "Invalid Calibration",
    29: "Crosscheck Fault",
    32: "HW Supervisor Fault",
    33: "KL30 UV",
    34: "KL30 OV",
    37: "LV Sensor Supply Fault",
}

L1_PWRSTG_FLAGS = [
    ("L1.0", "U-Low Driver", "Low-side phase U gate driver fault / power supply drop", 0x0001),
    ("L1.1", "U-High Driver", "High-side phase U gate driver fault / bootstrap failure", 0x0002),
    ("L1.2", "V-Low Driver", "Low-side phase V gate driver fault / power supply drop", 0x0004),
    ("L1.3", "V-High Driver", "High-side phase V gate driver fault / bootstrap failure", 0x0008),
    ("L1.4", "W-Low Driver", "Low-side phase W gate driver fault / power supply drop", 0x0010),
    ("L1.5", "W-High Driver", "High-side phase W gate driver fault / bootstrap failure", 0x0020),
    ("L1.6", "Desat (OC)", "IGBT desaturation detected (severe phase short/overcurrent)", 0x0040),
    ("L1.7", "PwrStg Overtemp", "Power stage module temperature exceeded hardware safety threshold", 0x0080),
    ("L1.8", "Gate Aux UV", "Auxiliary isolated power supply undervoltage on gate board", 0x0100),
]

L2_EMCTRL_FLAGS = [
    ("L2.0", "Current Sampling", "ADC current sensor offset calibration or sampling timing error", 0x01),
    ("L2.1", "Phase Current Clamped", "FOC peak stator phase current exceeded maximum control limit", 0x02),
    ("L2.2", "Rotor Pos Disagree", "Encoder / resolver electrical angle disagreement with observer", 0x04),
    ("L2.3", "Field Weakening", "D-axis field weakening current reached negative saturation limit", 0x08),
    ("L2.4", "Flux Observer", "Motor flux linkage observer state matrix saturated or unstable", 0x10),
    ("L2.5", "Speed Unlock", "Speed tracking observer PLL lost lock relative to electrical frequency", 0x20),
    ("L2.6", "DC Volt Transient", "Severe DC bus voltage rate-of-rise or transient spike detected", 0x40),
    ("L2.7", "Modulation Clamped", "SVPWM inverter modulation index reached over-modulation ceiling", 0x80),
]


# ══════════════════════════════════════════════════════════════════════════════
#  DIAGNOSTIC FLAG BADGE (INVERTER L1/L2 SUB-FAULTS)
# ══════════════════════════════════════════════════════════════════════════════
class DiagFlagBadge(QFrame):
    """Compact, high-contrast status badge for inverter L1/L2 diagnostic flags."""
    def __init__(self, code: str, title: str, tooltip: str, parent=None):
        super().__init__(parent)
        self.code = code
        self.title = title
        self._is_active = False
        self.setToolTip(f"<b>[{code}] {title}</b><br>{tooltip}")
        self.setFixedHeight(28)
        
        self.setStyleSheet(
            "QFrame { background:#141417; border:1px solid #27272a; border-radius:4px; }"
        )
        
        lay = QHBoxLayout(self)
        lay.setContentsMargins(6, 2, 6, 2)
        lay.setSpacing(6)
        
        self._code_lbl = QLabel(code)
        self._code_lbl.setStyleSheet("color:#71717a; font-size:10px; font-weight:bold; font-family:'Consolas', monospace; background:transparent; border:none;")
        self._code_lbl.setFixedWidth(30)
        
        self._title_lbl = QLabel(title)
        self._title_lbl.setStyleSheet(f"color:{F1_TEXT}; font-size:10.5px; font-weight:600; background:transparent; border:none;")
        
        self._status_lbl = QLabel("OK")
        self._status_lbl.setAlignment(Qt.AlignCenter)
        self._status_lbl.setFixedWidth(36)
        self._status_lbl.setStyleSheet("color:#10b981; background:#064e3b; font-size:9.5px; font-weight:bold; border-radius:3px; padding:1px; border:none;")
        
        lay.addWidget(self._code_lbl)
        lay.addWidget(self._title_lbl, stretch=1)
        lay.addWidget(self._status_lbl)

    def set_active(self, active: bool) -> None:
        if self._is_active == active:
            return
        self._is_active = active
        if active:
            self.setStyleSheet(
                "QFrame { background:#2a0808; border:1.5px solid #ef4444; border-radius:4px; }"
            )
            self._code_lbl.setStyleSheet("color:#fca5a5; font-size:10px; font-weight:bold; font-family:'Consolas', monospace; background:transparent; border:none;")
            self._title_lbl.setStyleSheet("color:#ffffff; font-size:10.5px; font-weight:bold; background:transparent; border:none;")
            self._status_lbl.setText("TRIP")
            self._status_lbl.setStyleSheet("color:#ffffff; background:#ef4444; font-size:9.5px; font-weight:bold; border-radius:3px; padding:1px; border:none;")
        else:
            self.setStyleSheet(
                "QFrame { background:#141417; border:1px solid #27272a; border-radius:4px; }"
            )
            self._code_lbl.setStyleSheet("color:#71717a; font-size:10px; font-weight:bold; font-family:'Consolas', monospace; background:transparent; border:none;")
            self._title_lbl.setStyleSheet(f"color:{F1_TEXT}; font-size:10.5px; font-weight:600; background:transparent; border:none;")
            self._status_lbl.setText("OK")
            self._status_lbl.setStyleSheet("color:#10b981; background:#064e3b; font-size:9.5px; font-weight:bold; border-radius:3px; padding:1px; border:none;")


# ══════════════════════════════════════════════════════════════════════════════
#  POWER ENVELOPE BAR (80 kW FORMULA STUDENT MONITOR)
# ══════════════════════════════════════════════════════════════════════════════
class PowerEnvelopeBar(QWidget):
    """Horizontal gauge bar visualizing DC/AC power against the Formula Student 80 kW limit."""
    def __init__(self, parent=None):
        super().__init__(parent)
        self._dc_kw = 0.0
        self._ac_kw = 0.0
        self.setFixedHeight(28)
        
    def set_power(self, dc_kw: float, ac_kw: float) -> None:
        if abs(self._dc_kw - dc_kw) < 0.1 and abs(self._ac_kw - ac_kw) < 0.1:
            return
        self._dc_kw = dc_kw
        self._ac_kw = ac_kw
        self.update()
        
    def paintEvent(self, event):
        painter = QPainter(self)
        painter.setRenderHint(QPainter.Antialiasing)
        w = float(self.width())
        h = float(self.height())
        
        # Background track
        bg_rect = QRectF(0, 4, w, h - 8)
        painter.setBrush(QColor("#18181b"))
        painter.setPen(QPen(QColor("#27272a"), 1))
        painter.drawRoundedRect(bg_rect, 4, 4)
        
        # 80 kW maximum limit
        max_limit = 80.0
        dc_val = max(0.0, self._dc_kw)
        fill_ratio = min(1.0, dc_val / max_limit) if max_limit > 0 else 0.0
        fill_w = max(0.0, (w - 2) * fill_ratio)
        
        # Bar color based on 80 kW proximity
        if dc_val > 80.0:
            bar_color = QColor("#ef4444")  # Rule breach red
        elif dc_val > 78.0:
            bar_color = QColor("#f97316")  # Critical margin orange
        elif dc_val > 72.0:
            bar_color = QColor("#f59e0b")  # Caution amber
        else:
            bar_color = QColor("#10b981")  # Nominal green
            
        if fill_w > 0:
            fill_rect = QRectF(1, 5, fill_w, h - 10)
            painter.setBrush(bar_color)
            painter.setPen(Qt.NoPen)
            painter.drawRoundedRect(fill_rect, 3, 3)
            
        # Draw 72 kW (90%) and 80 kW (100%) marker lines
        p90_x = (w - 2) * 0.90
        painter.setPen(QPen(QColor("#eab308"), 1.5, Qt.DashLine))
        painter.drawLine(int(p90_x), 2, int(p90_x), int(h - 2))


# ══════════════════════════════════════════════════════════════════════════════
#  RPM GAUGE  (circular, QPainter)
# ══════════════════════════════════════════════════════════════════════════════
class RPMGauge(QWidget):
    """Circular RPM gauge with green→yellow→red arc."""
    def __init__(self, parent=None):
        super().__init__(parent)
        self._rpm = 0.0
        self.setMinimumSize(180, 180)

    def set_rpm(self, rpm: float) -> None:
        new_rpm = max(0.0, min(float(rpm), RPM_MAX))
        if abs(self._rpm - new_rpm) < 1.0:
            return
        self._rpm = new_rpm
        if self.isVisible():
            self.update()

    def paintEvent(self, _ev):
        w, h  = self.width(), self.height()
        side  = min(w, h) - 12
        cx, cy = w // 2, h // 2
        r = side // 2

        p = QPainter(self)
        p.setRenderHint(QPainter.Antialiasing)

        # Background disc
        p.setPen(Qt.NoPen)
        p.setBrush(QBrush(QColor(F1_PANEL_BG)))
        p.drawEllipse(cx - r, cy - r, side, side)

        # Track
        track_w = max(8, r // 8)
        pad = track_w + 6
        rect_x, rect_y = cx - r + pad, cy - r + pad
        diam = (r - pad) * 2
        p.setPen(QPen(QColor('#2a2a2a'), track_w, Qt.SolidLine, Qt.RoundCap))
        p.setBrush(Qt.NoBrush)
        p.drawArc(rect_x, rect_y, diam, diam, 225 * 16, -270 * 16)

        # Coloured arc
        frac  = self._rpm / RPM_MAX
        sweep = int(frac * 270 * 16)
        col   = ISC_GREEN if frac < 0.60 else (F1_WARNING if frac < 0.85 else F1_ERROR)
        p.setPen(QPen(QColor(col), track_w, Qt.SolidLine, Qt.RoundCap))
        p.drawArc(rect_x, rect_y, diam, diam, 225 * 16, -sweep)

        # RPM text
        p.setPen(QColor(F1_TEXT))
        p.setFont(QFont("Segoe UI", max(11, r // 4), QFont.Bold))
        p.drawText(cx - r, cy - r // 3, side, side // 2, Qt.AlignCenter, f"{int(self._rpm):,}")

        p.setPen(QColor(col))
        p.setFont(QFont("Segoe UI", max(8, r // 9), QFont.Bold))
        p.drawText(cx - r, cy + r // 6, side, r // 2, Qt.AlignCenter, "RPM")
        p.end()


# ══════════════════════════════════════════════════════════════════════════════
#  PEDAL WIDGET  (vertical bar)
# ══════════════════════════════════════════════════════════════════════════════
class PedalWidget(QWidget):
    """Vertical bar pedal indicator with gradient fill."""
    def __init__(self, label: str, color: str = ISC_GREEN, parent=None):
        super().__init__(parent)
        self._label  = label
        self._color  = color
        self._norm   = 0.0   # 0.0 – 1.0
        self._raw    = 0
        self.setMinimumSize(90, 180)

    def set_value(self, normalized: float, raw: int = 0) -> None:
        new_norm = max(0.0, min(1.0, float(normalized)))
        if abs(self._norm - new_norm) < 0.005 and self._raw == raw:
            return
        self._norm = new_norm
        self._raw  = raw
        if self.isVisible():
            self.update()

    def paintEvent(self, _ev):
        w, h = self.width(), self.height()
        p = QPainter(self)
        p.setRenderHint(QPainter.Antialiasing)

        bw = int(w * 0.38)
        bh = int(h * 0.62)
        bx = (w - bw) // 2
        by = int(h * 0.10)

        # Track
        p.setPen(Qt.NoPen)
        p.setBrush(QBrush(QColor('#e0e0e0' if F1_TEXT == '#1a1a1a' else '#1e1e1e')))
        p.drawRoundedRect(bx, by, bw, bh, 4, 4)

        # Fill (bottom-up)
        fh = int(bh * self._norm)
        if fh > 0:
            grad = QLinearGradient(bx, by + bh, bx, by)
            grad.setColorAt(0.0, QColor(self._color))
            grad.setColorAt(1.0, QColor(self._color).lighter(140))
            p.setBrush(QBrush(grad))
            p.drawRoundedRect(bx, by + bh - fh, bw, fh, 4, 4)

        # Border
        p.setPen(QPen(QColor(self._color), 1))
        p.setBrush(Qt.NoBrush)
        p.drawRoundedRect(bx, by, bw, bh, 4, 4)

        # Label (top)
        p.setPen(QColor(self._color))
        p.setFont(QFont("Segoe UI", 9, QFont.Bold))
        p.drawText(0, 0, w, by, Qt.AlignCenter | Qt.AlignVCenter, self._label)

        # Percentage
        p.setPen(QColor(F1_TEXT))
        p.setFont(QFont("Segoe UI", 13, QFont.Bold))
        p.drawText(0, by + bh + 4, w, 22, Qt.AlignCenter, f"{int(self._norm * 100)}%")

        # Raw
        p.setPen(QColor(F1_MUTED))
        p.setFont(QFont("Segoe UI", 9))
        p.drawText(0, by + bh + 26, w, 16, Qt.AlignCenter, f"raw {self._raw}")
        p.end()


# ══════════════════════════════════════════════════════════════════════════════
#  G-FORCE CIRCLE
# ══════════════════════════════════════════════════════════════════════════════
class GCircleWidget(QWidget):
    """Circular G-force display with tracking dot."""
    MAX_G = 3.0

    def __init__(self, parent=None):
        super().__init__(parent)
        self._gx = 0.0   # lateral
        self._gy = 0.0   # longitudinal
        self._trail = deque(maxlen=15)
        self.setMinimumSize(160, 160)

    def set_g_force(self, g_long: float, g_lat: float) -> None:
        self._gx = g_lat
        self._gy = g_long
        self._trail.append((g_lat, g_long))
        if self.isVisible():
            self.update()

    def paintEvent(self, _ev):
        w, h = self.width(), self.height()
        r    = min(w, h) // 2 - 12
        cx, cy = w // 2, h // 2
        p = QPainter(self)
        p.setRenderHint(QPainter.Antialiasing)

        # Outer ring
        p.setPen(QPen(QColor('#3f3f46'), 1.5))
        p.setBrush(QBrush(QColor(F1_PANEL_BG)))
        p.drawEllipse(cx - r, cy - r, r * 2, r * 2)

        # Inner rings (1 G, 2 G)
        for frac in (1/3, 2/3):
            rr = int(r * frac)
            p.setPen(QPen(QColor('#2e2e34'), 1, Qt.DashLine))
            p.setBrush(Qt.NoBrush)
            p.drawEllipse(cx - rr, cy - rr, rr * 2, rr * 2)

        # Cross-hairs
        p.setPen(QPen(QColor('#2e2e34'), 1))
        p.drawLine(cx - r, cy, cx + r, cy)
        p.drawLine(cx, cy - r, cx, cy + r)

        # G-Force vector trails
        num_points = len(self._trail)
        for idx, (gx, gy) in enumerate(self._trail):
            nx = max(-1.0, min(1.0, gx / self.MAX_G))
            ny = max(-1.0, min(1.0, gy / self.MAX_G))
            tx = int(cx + nx * r)
            ty = int(cy - ny * r)
            
            # Fading opacity and size for trailing path
            alpha = int(((idx + 1) / (num_points + 1)) * 140)
            dot_size = max(2, int(8 * ((idx + 1) / (num_points + 1))))
            p.setPen(Qt.NoPen)
            p.setBrush(QBrush(QColor(239, 68, 68, alpha)))  # Red trail
            p.drawEllipse(tx - dot_size // 2, ty - dot_size // 2, dot_size, dot_size)

        # Main active G-dot
        nx = max(-1.0, min(1.0, self._gx / self.MAX_G))
        ny = max(-1.0, min(1.0, self._gy / self.MAX_G))
        dot_x = int(cx + nx * r)
        dot_y = int(cy - ny * r)
        p.setPen(Qt.NoPen)
        p.setBrush(QBrush(QColor(ISC_GREEN)))
        p.drawEllipse(dot_x - 6, dot_y - 6, 12, 12)

        # Axis labels
        p.setPen(QColor(F1_MUTED))
        p.setFont(QFont("Segoe UI", 9, QFont.Bold))
        p.drawText(cx - r, cy + r + 3, r * 2, 14, Qt.AlignCenter, "← LAT →")
        p.end()


# ══════════════════════════════════════════════════════════════════════════════
#  GPS TRACK MAP WIDGET
# ══════════════════════════════════════════════════════════════════════════════
import math as _math

class GPSTrackWidget(QWidget):
    """
    Real-time GPS track map drawn with QPainter.
    Uses equirectangular local XY projection (origin = first GPS fix).
    No external map tiles / internet required. Full dark & light theme support.
    """
    TRAIL_MAXLEN = 2000   # ~10 min at 3 Hz
    MIN_MOVE_M   = 0.5    # minimum displacement (m) before appending a new point

    def __init__(self, parent=None):
        super().__init__(parent)
        self._trail: deque = deque(maxlen=self.TRAIL_MAXLEN)  # (x_m, y_m)
        self._origin_lat: float | None = None   # degrees
        self._origin_lon: float | None = None   # degrees
        self._cur_x: float = 0.0   # metres east  from origin
        self._cur_y: float = 0.0   # metres north from origin
        self._cur_spd: float = 0.0  # km/h
        self._cur_hdg: float = 0.0  # degrees (course over ground)
        self._has_fix: bool = False
        self._sats: int = 0
        self._lat: float = 0.0
        self._lon: float = 0.0
        self.setMinimumSize(200, 200)

    # ── coordinate helpers ──────────────────────────────────────────────────
    @staticmethod
    def _latlon_to_xy(lat: float, lon: float,
                      lat0: float, lon0: float) -> tuple[float, float]:
        """Equirectangular projection → (east_m, north_m) from (lat0, lon0)."""
        R = 6_371_000.0
        dlat = _math.radians(lat - lat0)
        dlon = _math.radians(lon - lon0)
        cos_lat0 = _math.cos(_math.radians(lat0))
        return dlon * R * cos_lat0, dlat * R

    # ── public API ──────────────────────────────────────────────────────────
    def update_gps(self, lat: float, lon: float,
                   speed_kmh: float, course_deg: float,
                   has_fix: bool, sats: int) -> None:
        self._has_fix = has_fix
        self._sats    = sats
        self._lat     = lat
        self._lon     = lon
        self._cur_spd = speed_kmh
        self._cur_hdg = course_deg

        if has_fix:
            if self._origin_lat is None:
                # Anchor origin on first good fix
                self._origin_lat = lat
                self._origin_lon = lon
                self._cur_x, self._cur_y = 0.0, 0.0
                self._trail.append((0.0, 0.0))
            else:
                x, y = self._latlon_to_xy(lat, lon,
                                          self._origin_lat, self._origin_lon)
                self._cur_x, self._cur_y = x, y
                # Only append if car has moved enough to avoid GPS jitter
                if self._trail:
                    lx, ly = self._trail[-1]
                    if _math.hypot(x - lx, y - ly) >= self.MIN_MOVE_M:
                        self._trail.append((x, y))
                else:
                    self._trail.append((x, y))
        if self.isVisible():
            self.update()   # trigger paintEvent

    def reset_track(self) -> None:
        """Clear accumulated trail (use when starting a new session)."""
        self._trail.clear()
        self._origin_lat = None
        self._origin_lon = None
        self.update()

    # ── painting ────────────────────────────────────────────────────────────
    def paintEvent(self, _ev):
        is_light = (F1_TEXT == '#1a1a1a')
        bg       = QColor(F1_PANEL_BG)
        border   = QColor('#bbbbbb' if is_light else '#333333')
        trail_c  = QColor('#0d9afe' if is_light else '#00b4fc')  # bright blue
        dot_c    = QColor(ISC_GREEN)
        axis_c   = QColor('#888888' if is_light else '#555555')
        txt_c    = QColor('#111111' if is_light else '#cccccc')
        no_fix_c = QColor('#cc4444')
        hdg_c    = QColor('#ff8800')   # heading arrow

        w, h = self.width(), self.height()
        pad  = 12
        map_x, map_y   = pad, pad
        map_w, map_h   = w - 2 * pad, h - 2 * pad - 36   # bottom 36px for info bar

        p = QPainter(self)
        p.setRenderHint(QPainter.Antialiasing)

        # ── background ──────────────────────────────────────────────────────
        p.fillRect(0, 0, w, h, bg)

        # ── map frame ───────────────────────────────────────────────────────
        p.setPen(QPen(border, 1))
        p.setBrush(QBrush(QColor('#f8faff' if is_light else '#0d0d0d')))
        p.drawRoundedRect(map_x, map_y, map_w, map_h, 6, 6)

        # ── grid lines ──────────────────────────────────────────────────────
        grid_c = QColor('#cccccc' if is_light else '#1c1c1c')
        p.setPen(QPen(grid_c, 1, Qt.DotLine))
        for frac in (0.25, 0.5, 0.75):
            gx = int(map_x + frac * map_w)
            gy = int(map_y + frac * map_h)
            p.drawLine(gx, map_y, gx, map_y + map_h)
            p.drawLine(map_x, gy, map_x + map_w, gy)

        if not self._trail or self._origin_lat is None:
            # ── No GPS fix yet ─────────────────────────────────────────────
            p.setPen(no_fix_c)
            p.setFont(QFont("Courier New", 9, QFont.Bold))
            p.drawText(map_x, map_y, map_w, map_h, Qt.AlignCenter,
                       "NO GPS FIX\nWaiting for signal…")
        else:
            # ── Compute bounding box of trail for auto-zoom ─────────────────
            xs = [pt[0] for pt in self._trail]
            ys = [pt[1] for pt in self._trail]
            xs.append(self._cur_x); ys.append(self._cur_y)
            min_x, max_x = min(xs), max(xs)
            min_y, max_y = min(ys), max(ys)
            span_x = max(max_x - min_x, 20.0)   # metres, minimum 20 m
            span_y = max(max_y - min_y, 20.0)
            # uniform scale with 10% padding
            scale = min(map_w * 0.85 / span_x, map_h * 0.85 / span_y)
            cx0   = map_x + map_w / 2 - (min_x + max_x) / 2 * scale
            cy0   = map_y + map_h / 2 + (min_y + max_y) / 2 * scale

            def world_to_screen(xm, ym):
                return cx0 + xm * scale, cy0 - ym * scale

            # ── Draw trail ─────────────────────────────────────────────────
            pts = list(self._trail)
            n   = len(pts)
            if n >= 2:
                pen = QPen(trail_c, 2, Qt.SolidLine, Qt.RoundCap, Qt.RoundJoin)
                p.setPen(pen)
                p.setBrush(Qt.NoBrush)
                path_pts = [world_to_screen(x, y) for x, y in pts]
                for i in range(1, len(path_pts)):
                    # Fade older segments to grey
                    alpha = int(80 + 175 * i / n)
                    fade_c = QColor(trail_c)
                    fade_c.setAlpha(alpha)
                    p.setPen(QPen(fade_c, 2, Qt.SolidLine, Qt.RoundCap))
                    x1, y1 = path_pts[i - 1]
                    x2, y2 = path_pts[i]
                    p.drawLine(int(x1), int(y1), int(x2), int(y2))

            # ── Origin dot (start of session) ──────────────────────────────
            ox, oy = world_to_screen(0, 0)
            p.setPen(Qt.NoPen)
            p.setBrush(QBrush(QColor('#ff4444')))
            p.drawEllipse(int(ox) - 5, int(oy) - 5, 10, 10)

            # ── Heading arrow ─────────────────────────────────────────────
            sx, sy = world_to_screen(self._cur_x, self._cur_y)
            arrow_len = 18
            hdg_rad   = _math.radians(self._cur_hdg)
            ax = sx + arrow_len * _math.sin(hdg_rad)
            ay = sy - arrow_len * _math.cos(hdg_rad)
            p.setPen(QPen(hdg_c, 2))
            p.drawLine(int(sx), int(sy), int(ax), int(ay))
            # arrowhead
            perp = _math.radians(self._cur_hdg + 150)
            perp2= _math.radians(self._cur_hdg - 150)
            ahl  = 8
            p.drawLine(int(ax), int(ay),
                       int(ax + ahl * _math.sin(perp)),  int(ay - ahl * _math.cos(perp)))
            p.drawLine(int(ax), int(ay),
                       int(ax + ahl * _math.sin(perp2)), int(ay - ahl * _math.cos(perp2)))

            # ── Live car dot ──────────────────────────────────────────────
            p.setPen(QPen(QColor('#000000'), 1))
            p.setBrush(QBrush(dot_c))
            p.drawEllipse(int(sx) - 7, int(sy) - 7, 14, 14)

            # ── Scale bar (20 m) ──────────────────────────────────────────
            bar_px   = int(20 * scale)
            bar_x0   = map_x + 8
            bar_y0   = map_y + map_h - 10
            p.setPen(QPen(axis_c, 2))
            p.drawLine(bar_x0, bar_y0, bar_x0 + bar_px, bar_y0)
            p.drawLine(bar_x0, bar_y0 - 4, bar_x0, bar_y0 + 1)
            p.drawLine(bar_x0 + bar_px, bar_y0 - 4, bar_x0 + bar_px, bar_y0 + 1)
            p.setPen(txt_c)
            p.setFont(QFont("Courier New", 7))
            p.drawText(bar_x0, bar_y0 - 12, bar_px + 2, 12, Qt.AlignCenter, "20 m")

        # ── Info bar at bottom ──────────────────────────────────────────────
        info_y = map_y + map_h + 4
        info_h = h - info_y - 2
        p.setPen(txt_c)
        p.setFont(QFont("Courier New", 8, QFont.Bold))

        if self._has_fix:
            fix_dot_c = QColor(ISC_GREEN)
            spd_txt   = f"  {self._cur_spd:.1f} km/h"
            sat_txt   = f"  {self._sats} sats"
            lat_txt   = f"  {self._lat:+.5f}°"
            lon_txt   = f"  {self._lon:+.5f}°"
            trail_txt = f"  {len(self._trail)} pts"
            info_str  = f"GPS ●  {self._cur_spd:.1f} km/h   Hdg {self._cur_hdg:.0f}°   Sats {self._sats}   {self._lat:+.5f}° {self._lon:+.5f}°   Trail {len(self._trail)} pts"
        else:
            fix_dot_c = no_fix_c
            info_str  = f"GPS ✕   NO FIX   Sats {self._sats}"

        # Status dot
        p.setPen(Qt.NoPen)
        p.setBrush(fix_dot_c)
        dot_r = 5
        p.drawEllipse(pad, info_y + (info_h - dot_r * 2) // 2, dot_r * 2, dot_r * 2)

        p.setPen(txt_c)
        p.setFont(QFont("Courier New", 7))
        p.drawText(pad + dot_r * 2 + 4, info_y, w - pad * 2, info_h,
                   Qt.AlignVCenter | Qt.AlignLeft, info_str)
        p.end()


# ══════════════════════════════════════════════════════════════════════════════
#  MODULE BAR WIDGET
# ══════════════════════════════════════════════════════════════════════════════
class ModuleBarWidget(QWidget):
    """Horizontal progress bar for per-module voltage or temperature."""
    def __init__(self, module_id: int, unit: str = "mV",
                 lo: float = 2800, hi: float = 4250,
                 warn_lo: Optional[float] = None,
                 warn_hi: Optional[float] = None,
                 parent=None):
        super().__init__(parent)
        self._id       = module_id
        self._unit     = unit
        self._lo_range = lo
        self._hi_range = hi
        self._warn_lo  = warn_lo
        self._warn_hi  = warn_hi
        self._val_lo   = lo
        self._val_hi   = lo
        self.setFixedHeight(32)

    def set_values(self, lo: float, hi: float) -> None:
        flo = float(lo)
        fhi = float(hi)
        if abs(self._val_lo - flo) < 0.5 and abs(self._val_hi - fhi) < 0.5:
            return
        self._val_lo = flo
        self._val_hi = fhi
        if self.isVisible():
            self.update()

    def _frac(self, v: float) -> float:
        span = self._hi_range - self._lo_range
        return (v - self._lo_range) / span if span else 0.0

    def paintEvent(self, _ev):
        w, h = self.width(), self.height()
        p = QPainter(self)
        p.setRenderHint(QPainter.Antialiasing)

        lw   = 62
        vw   = 100
        bx   = lw + 6
        bw   = w - bx - vw - 4
        bh   = 13
        by   = (h - bh) // 2

        # Module label
        p.setPen(QColor(ISC_GREEN))
        p.setFont(QFont("Segoe UI", 10, QFont.Bold))
        p.drawText(2, 0, lw, h, Qt.AlignVCenter | Qt.AlignLeft, f"MOD {self._id}")

        # Track
        p.setPen(Qt.NoPen)
        p.setBrush(QBrush(QColor('#e0e0e0' if F1_TEXT == '#1a1a1a' else '#1e1e1e')))
        p.drawRoundedRect(bx, by, bw, bh, 3, 3)

        # Filled range
        alert = ((self._warn_hi is not None and self._val_hi > self._warn_hi) or
                 (self._warn_lo is not None and self._val_lo < self._warn_lo))
        col = QColor(F1_ERROR if alert else ISC_GREEN)

        x0 = bx + int(max(0, min(1, self._frac(self._val_lo))) * bw)
        x1 = bx + int(max(0, min(1, self._frac(self._val_hi))) * bw)
        fill_w = max(4, x1 - x0)
        p.setBrush(QBrush(col))
        p.drawRoundedRect(x0, by, fill_w, bh, 3, 3)

        # Threshold lines
        for thresh, tcol in [(self._warn_hi, F1_WARNING), (self._warn_lo, F1_ERROR)]:
            if thresh is not None:
                tx = bx + int(max(0, min(1, self._frac(thresh))) * bw)
                p.setPen(QPen(QColor(tcol), 2))
                p.drawLine(tx, by - 3, tx, by + bh + 3)

        # Value text
        p.setPen(QColor(F1_TEXT))
        p.setFont(QFont("Consolas", 10, QFont.Bold))
        p.drawText(bx + bw + 6, 0, vw, h, Qt.AlignVCenter | Qt.AlignLeft,
                   f"{self._val_lo:.0f}–{self._val_hi:.0f} {self._unit}")
        p.end()



# ══════════════════════════════════════════════════════════════════════════════
#  SIGNAL BARS WIDGET  — WiFi-style link quality indicator
# ══════════════════════════════════════════════════════════════════════════════
class SignalBarsWidget(QWidget):
    """
    Draws 4 rising bars like a WiFi / mobile signal indicator.
      lqi >= 85 %  → 4 bars, green
      lqi >= 70 %  → 3 bars, green-yellow
      lqi >= 50 %  → 2 bars, orange
      lqi >= 25 %  → 1 bar,  red
      lqi <  25 %  → 0 bars (all bars dim), red
    """
    _THRESHOLDS = [85, 70, 50, 25]   # 4,3,2,1 active bars
    _COLOURS = {
        4: "#00c853",  # green
        3: "#8bc34a",  # yellow-green
        2: "#f0b429",  # orange
        1: "#ef4444",  # red
        0: "#ef4444",  # red (all dim)
    }

    def __init__(self, parent=None):
        super().__init__(parent)
        self._lqi = 100.0
        self.setFixedSize(36, 22)
        self.setToolTip("Link Quality Indicator (packet success rate, last 50 snapshots)")

    def set_lqi(self, lqi: float):
        if lqi != self._lqi:
            self._lqi = lqi
            self.update()

    def _active_bars(self) -> int:
        for i, thr in enumerate(self._THRESHOLDS):
            if self._lqi >= thr:
                return 4 - i
        return 0

    def paintEvent(self, event):
        p = QPainter(self)
        p.setRenderHint(QPainter.Antialiasing)

        n_active = self._active_bars()
        colour   = QColor(self._COLOURS[n_active])
        dim      = QColor("#2a2a2a")

        num_bars  = 4
        margin    = 2
        w         = self.width()
        h         = self.height()
        bar_w     = max(4, (w - margin * (num_bars + 1)) // num_bars)
        max_bar_h = h - margin * 2

        for i in range(num_bars):
            bar_h   = int(max_bar_h * (i + 1) / num_bars)
            bx      = margin + i * (bar_w + margin)
            by      = h - margin - bar_h
            active  = i < n_active
            p.setBrush(colour if active else dim)
            p.setPen(Qt.NoPen)
            p.drawRoundedRect(bx, by, bar_w, bar_h, 2, 2)

        p.end()



class ChannelListWidget(QListWidget):
    """Drag-enabled list of snapshot channel names."""
    def __init__(self, parent=None):
        super().__init__(parent)
        self.setDragEnabled(True)
        self.setDefaultDropAction(Qt.CopyAction)
        self.setStyleSheet(f"""
            QListWidget {{
                background: {F1_PANEL_BG}; color: {F1_TEXT};
                border: 1px solid #3f3f46; font-size: 11px; font-weight: 500;
                border-radius: 4px; padding: 4px;
            }}
            QListWidget::item {{
                padding: 4px 6px; border-radius: 2px;
            }}
            QListWidget::item:selected {{ background: {ISC_GREEN}; color: #000000; font-weight: bold; }}
            QListWidget::item:hover    {{ background: #2a2a30; }}
        """)
        for key, (label, unit) in SNAPSHOT_CHANNELS.items():
            display = f"{label}  [{unit}]" if unit else label
            item = QListWidgetItem(display)
            item.setData(Qt.UserRole, key)
            self.addItem(item)

    def startDrag(self, _actions):
        item = self.currentItem()
        if not item:
            return
        drag = QDrag(self)
        mime = QMimeData()
        mime.setText(item.data(Qt.UserRole))
        drag.setMimeData(mime)
        drag.exec_(Qt.CopyAction)


class DroppablePlotPanel(QFrame):
    """A panel that accepts a channel drop and shows a rolling plot."""
    def __init__(self, idx: int, parent=None):
        super().__init__(parent)
        self._idx     = idx
        self._channel: Optional[str] = None
        self._history: Deque[float]  = deque([0.0] * HISTORY_LEN, maxlen=HISTORY_LEN)
        self.setAcceptDrops(True)
        self.setMinimumHeight(155)
        self._border_idle()

        lay = QVBoxLayout(self)
        lay.setContentsMargins(6, 6, 6, 6)
        lay.setSpacing(3)

        # Header
        hdr = QHBoxLayout()
        self._title_lbl = QLabel(f"Drop channel here  (panel {idx})")
        self._title_lbl.setStyleSheet("color:#94a3b8; font-size:11px; font-weight:bold; background:transparent; border:none;")
        hdr.addWidget(self._title_lbl)
        hdr.addStretch()
        btn_clr = QPushButton("✕")
        btn_clr.setFixedSize(18, 18)
        btn_clr.setStyleSheet(
            f"QPushButton {{ background:#2a2a30; color:#94a3b8; border:none; font-size:10px; font-weight:bold; border-radius:2px; }}"
            f"QPushButton:hover {{ background:{F1_ERROR}; color:white; }}"
        )
        btn_clr.clicked.connect(self.clear_channel)
        hdr.addWidget(btn_clr)
        lay.addLayout(hdr)

        # Matplotlib canvas
        fig = Figure(figsize=(3, 1.4), tight_layout=True)
        fig.patch.set_facecolor(F1_PANEL_BG)
        self._ax = fig.add_subplot(111)
        self._line, = self._ax.plot([], [], color=ISC_GREEN, linewidth=1.2)
        self._ax.set_facecolor(F1_DARK_BG)
        self._ax.tick_params(labelsize=8.5, colors='#ffffff' if F1_TEXT == '#f1f5f9' else '#111111')
        self._ax.grid(True, color='#444444' if F1_TEXT == '#f1f5f9' else '#cccccc', alpha=0.35)
        for s in self._ax.spines.values():
            s.set_color('#555555' if F1_TEXT == '#f1f5f9' else '#aaaaaa')
        self._canvas = FigureCanvas(fig)
        lay.addWidget(self._canvas)

        # Current value
        self._val_lbl = QLabel("—")
        self._val_lbl.setAlignment(Qt.AlignCenter)
        self._val_lbl.setStyleSheet(f"color:{ISC_GREEN}; font-size:16px; font-weight:bold; background:transparent; border:none;")
        lay.addWidget(self._val_lbl)

    # ── drag-drop events ──────────────────────────────────────────────────────
    def dragEnterEvent(self, ev):
        if ev.mimeData().hasText():
            self.setStyleSheet(f"QFrame {{ background:{F1_PANEL_BG}; border:2px solid {ISC_GREEN}; border-radius:4px; }}")
            ev.acceptProposedAction()

    def dragLeaveEvent(self, _ev):
        self._border_idle()

    def dropEvent(self, ev):
        self.assign_channel(ev.mimeData().text())
        self.setStyleSheet(f"QFrame {{ background:{F1_PANEL_BG}; border:1px solid {ISC_GREEN}; border-radius:4px; }}")
        ev.acceptProposedAction()

    def _border_idle(self):
        self.setStyleSheet(f"QFrame {{ background:{F1_PANEL_BG}; border:1px dashed #3f3f46; border-radius:4px; }}")

    # ── assignment ────────────────────────────────────────────────────
    def assign_channel(self, key: str) -> None:
        self._channel = key
        label, unit = SNAPSHOT_CHANNELS.get(key, (key, ''))
        self._unit = unit
        title_txt = f"{label}  [{unit}]" if unit else label
        self._title_lbl.setText(title_txt)
        self._title_lbl.setStyleSheet(
            f"color:{ISC_GREEN}; font-size:11px; font-weight:bold; background:transparent; border:none;")
        # Update y-axis label with unit
        self._ax.set_ylabel(unit, fontsize=8, color=F1_MUTED)
        self._history = deque([0.0] * HISTORY_LEN, maxlen=HISTORY_LEN)

    def clear_channel(self) -> None:
        self._channel = None
        self._unit = ''
        self._title_lbl.setText(f"Drop channel here  (panel {self._idx})")
        self._title_lbl.setStyleSheet("color:#94a3b8; font-size:11px; font-weight:bold; background:transparent; border:none;")
        self._history  = deque([0.0] * HISTORY_LEN, maxlen=HISTORY_LEN)
        self._val_lbl.setText("—")
        self._ax.cla()
        self._ax.set_facecolor(F1_DARK_BG)
        self._ax.tick_params(labelsize=8.5, colors='#ffffff' if F1_TEXT == '#f1f5f9' else '#111111')
        self._ax.grid(True, color='#444444' if F1_TEXT == '#f1f5f9' else '#cccccc', alpha=0.35)
        for s in self._ax.spines.values():
            s.set_color('#555555' if F1_TEXT == '#f1f5f9' else '#aaaaaa')
        self._line, = self._ax.plot([], [], color=ISC_GREEN, linewidth=1.2)
        self._canvas.draw_idle()
        self._border_idle()

    def update_value(self, snapshot: dict) -> None:
        if not self._channel:
            return
        # Flat key lookup first; then handle per-module array channels
        key = self._channel
        if key in snapshot:
            raw = snapshot[key]
            val = float(raw[0] if isinstance(raw, list) else raw)
        elif key.startswith('vmin_modulo_'):
            idx = int(key[-1])
            arr = snapshot.get('vmin_modulo', [])
            val = float(arr[idx]) if idx < len(arr) else 0.0
        elif key.startswith('vmax_modulo_'):
            idx = int(key[-1])
            arr = snapshot.get('vmax_modulo', [])
            val = float(arr[idx]) if idx < len(arr) else 0.0
        elif key.startswith('tmax_modulo_'):
            idx = int(key[-1])
            arr = snapshot.get('temp_max_modulo', [])
            val = float(arr[idx]) if idx < len(arr) else 0.0
        else:
            val = 0.0
        self._history.append(val)
        unit = getattr(self, '_unit', '')
        self._val_lbl.setText(f"{val:.1f} {unit}" if unit else f"{val:.1f}")
        if not self.isVisible():
            return
        y = list(self._history)
        x = list(range(len(y)))
        self._line.set_data(x, y)
        lo, hi = min(y), max(y)
        mg = max((hi - lo) * 0.1, 1.0)
        self._ax.set_xlim(0, HISTORY_LEN)
        self._ax.set_ylim(lo - mg, hi + mg)
        self._canvas.draw_idle()


# ══════════════════════════════════════════════════════════════════════════════
#  SETTINGS DIALOG
# ══════════════════════════════════════════════════════════════════════════════
class SettingsDialog(QDialog):
    def __init__(self, parent: 'MainWindow' = None):
        super().__init__(parent)
        self.setWindowTitle("ISCmetrics — Ajustes")
        self.setWindowFlags(self.windowFlags() & ~Qt.WindowContextHelpButtonHint)
        self.setGeometry(200, 200, 460, 430)
        self._p = parent
        if parent:
            self.setPalette(parent.palette())
        
        # High-contrast premium style sheet with embedded vector checkmark
        self.setStyleSheet(f"""
            QDialog {{
                background: {F1_DARK_BG};
                color: {F1_TEXT};
            }}
            QCheckBox {{
                color: {F1_TEXT};
                font-size: 11px;
                spacing: 8px;
            }}
            QCheckBox#chk_demo {{
                color: {ISC_GREEN};
                font-weight: bold;
            }}
            QCheckBox::indicator {{
                width: 14px;
                height: 14px;
                border: 1.5px solid #555555;
                background-color: {F1_MID_BG};
                border-radius: 3px;
            }}
            QCheckBox::indicator:hover {{
                border: 1.5px solid {ISC_GREEN};
            }}
            QCheckBox::indicator:checked {{
                border: 1.5px solid {ISC_GREEN};
                background-color: {F1_MID_BG};
                image: url(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);
            }}
        """)
        self._build()

    def _build(self):
        g = QGridLayout(self)
        g.setSpacing(10)
        g.setContentsMargins(16, 16, 16, 16)
        ls  = f"color:{F1_TEXT}; font-size:11px; font-weight:bold;"
        ins = self._p.get_input_style()

        g.addWidget(self._lbl("COM Port:", ls), 0, 0)
        port_row = QHBoxLayout()
        self.combo_port = QComboBox(); self.combo_port.setStyleSheet(ins)
        self._refresh_ports()
        port_row.addWidget(self.combo_port, stretch=1)
        btn_refresh = QPushButton("⟳")
        btn_refresh.setFixedWidth(28)
        btn_refresh.setToolTip("Refresh COM ports")
        btn_refresh.setStyleSheet(self._p.get_button_style())
        btn_refresh.clicked.connect(self._refresh_ports)
        port_row.addWidget(btn_refresh)
        port_container = QWidget(); port_container.setLayout(port_row)
        g.addWidget(port_container, 0, 1)

        g.addWidget(self._lbl("Baud Rate:", ls), 1, 0)
        self.input_baud = QLineEdit(str(self._p.settings.get("baud", rtt.DEFAULT_BAUD))); self.input_baud.setStyleSheet(ins)
        g.addWidget(self.input_baud, 1, 1)

        self.chk_marple = QCheckBox("Upload to Marple Data (cloud)  🔒")
        self.chk_marple.setChecked(self._p.settings.get("use_influx", False))
        self.chk_marple.stateChanged.connect(self._on_marple_toggled)
        g.addWidget(self.chk_marple, 2, 0, 1, 2)

        self.chk_debug = QCheckBox("Enable debug output")
        self.chk_debug.setChecked(self._p.settings.get("debug", False))
        g.addWidget(self.chk_debug, 3, 0, 1, 2)

        self.chk_demo = QCheckBox("Demo mode  (simulated data)")
        self.chk_demo.setObjectName("chk_demo")
        self.chk_demo.setChecked(self._p.settings.get("demo_mode", False))
        g.addWidget(self.chk_demo, 4, 0, 1, 2)

        self.chk_tts = QCheckBox("Enable voice alerts (TTS)")
        self.chk_tts.setChecked(self._p.settings.get("enable_tts", True))
        g.addWidget(self.chk_tts, 5, 0, 1, 2)

        # Alert thresholds
        g.addWidget(self._lbl("Alert Max Temp (°C):", ls), 6, 0)
        self.input_alert_temp = QLineEdit(str(self._p.settings.get("alert_temp_c", 40.0)))
        self.input_alert_temp.setStyleSheet(ins)
        g.addWidget(self.input_alert_temp, 6, 1)

        g.addWidget(self._lbl("Alert Min DC Bus (V):", ls), 7, 0)
        self.input_alert_volt = QLineEdit(str(self._p.settings.get("alert_volt_v", 380.0)))
        self.input_alert_volt.setStyleSheet(ins)
        g.addWidget(self.input_alert_volt, 7, 1)

        g.addWidget(self._lbl("Alert Min Cell (mV):", ls), 8, 0)
        self.input_alert_cell = QLineEdit(str(self._p.settings.get("alert_cell_mv", 3400.0)))
        self.input_alert_cell.setStyleSheet(ins)
        g.addWidget(self.input_alert_cell, 8, 1)

        g.addWidget(self._lbl("Alert Cell Imbalance (mV):", ls), 9, 0)
        self.input_alert_imb = QLineEdit(str(self._p.settings.get("alert_cell_imb_mv", 100.0)))
        self.input_alert_imb.setStyleSheet(ins)
        self.input_alert_imb.setToolTip("Alert when max(Vmax-Vmin) across any module exceeds this value")
        g.addWidget(self.input_alert_imb, 9, 1)

        # Separator line
        sep = QFrame(); sep.setFrameShape(QFrame.HLine)
        sep.setStyleSheet("color:#333; margin-top:4px; margin-bottom:4px;")
        g.addWidget(sep, 10, 0, 1, 2)

        # Accept button (row 11)
        btn = QPushButton("✔  Apply & Close")
        btn.setStyleSheet(self._p.get_button_style('accent'))
        btn.setToolTip("Save settings and close this dialog")
        btn.clicked.connect(self.accept)
        g.addWidget(btn, 11, 0, 1, 2)

        # Calibrate pedals — separate row (row 12)
        btn_cal = QPushButton("⚙  Calibrate Pedals…")
        btn_cal.setStyleSheet(self._p.get_button_style())
        btn_cal.setToolTip("Launch the brake & APPS live calibration wizard (connects to car automatically)")
        btn_cal.clicked.connect(self._open_cal_wizard)
        g.addWidget(btn_cal, 12, 0, 1, 2)


    # ── Marple password gate ──────────────────────────────────────────────────


# ══════════════════════════════════════════════════════════════════════════════
#  FAULT HISTORY DIALOG
# ══════════════════════════════════════════════════════════════════════════════
class FaultHistoryDialog(QDialog):
    """Read-only table of all fault events persisted in fault_history.json."""
    def __init__(self, parent=None):
        super().__init__(parent)
        self.setWindowTitle("ISCmetrics - Fault History Log")
        self.setWindowFlags(self.windowFlags() & ~Qt.WindowContextHelpButtonHint)
        self.setGeometry(200, 150, 820, 480)
        self.setStyleSheet(f"background:{F1_DARK_BG}; color:{F1_TEXT};")
        self._build()

    def _build(self):
        import json
        v = QVBoxLayout(self)
        v.setContentsMargins(12, 12, 12, 12)

        title = QLabel("Fault Event History  (all sessions)")
        title.setStyleSheet(f"color:{ISC_GREEN}; font-size:13px; font-weight:bold;")
        v.addWidget(title)

        cols = ["Timestamp", "Session", "Kind", "DEM", "Description", "Detail"]
        tbl = QTableWidget(0, len(cols))
        tbl.setHorizontalHeaderLabels(cols)
        tbl.setEditTriggers(QTableWidget.NoEditTriggers)
        tbl.setSelectionBehavior(QTableWidget.SelectRows)
        tbl.horizontalHeader().setStretchLastSection(True)
        tbl.setStyleSheet(f"""
            QTableWidget {{ background:{F1_MID_BG}; color:{F1_TEXT};
                            gridline-color:#333; border:none; font-size:10px; }}
            QHeaderView::section {{ background:{F1_PANEL_BG}; color:{ISC_GREEN};
                                    font-size:10px; font-weight:bold; border:none; padding:4px; }}
            QTableWidget::item:selected {{ background:{ISC_GREEN}; color:{F1_DARK_BG}; }}
        """)
        fault_file = rtt.USER_DIR / "fault_history.json"
        events = []
        if fault_file.exists():
            try:
                with open(fault_file, "r") as f:
                    events = json.load(f)
            except Exception:
                events = []
        tbl.setRowCount(len(events))
        from PyQt5.QtGui import QColor
        for row, ev in enumerate(reversed(events)):
            vals = [ev.get("ts",""), ev.get("session",""), ev.get("kind",""),
                    str(ev.get("dem_code","")), ev.get("dem_desc",""), ev.get("detail","")]
            for col, val in enumerate(vals):
                item = QTableWidgetItem(val)
                if ev.get("kind") == "APPS_IMPL":
                    item.setForeground(QColor(F1_WARNING))
                elif ev.get("dem_code", 0):
                    item.setForeground(QColor(F1_ERROR))
                tbl.setItem(row, col, item)
        tbl.resizeColumnsToContents()
        v.addWidget(tbl)
        if not events:
            lbl = QLabel("No fault events recorded yet.")
            lbl.setStyleSheet("color:#555; font-size:11px; padding:8px;")
            lbl.setAlignment(Qt.AlignCenter)
            v.addWidget(lbl)
        row_btns = QHBoxLayout()
        btn_clear = QPushButton("Clear History")
        btn_clear.setStyleSheet(
            f"QPushButton{{background:{F1_ERROR};color:white;border:none;border-radius:3px;padding:5px 12px;font-size:10px;}}"
            f"QPushButton:hover{{background:#dc2626;}}")
        btn_clear.clicked.connect(lambda: self._clear(fault_file, tbl))
        row_btns.addWidget(btn_clear)
        row_btns.addStretch()
        btn_close = QPushButton("Close")
        btn_close.setStyleSheet(
            f"QPushButton{{background:{F1_PANEL_BG};color:{F1_TEXT};border:1px solid #444;border-radius:3px;padding:5px 14px;font-size:10px;}}"
            f"QPushButton:hover{{border-color:{ISC_GREEN};}}")
        btn_close.clicked.connect(self.accept)
        row_btns.addWidget(btn_close)
        v.addLayout(row_btns)

    def _clear(self, fault_file, tbl):
        import json
        reply = QMessageBox.question(self, "Clear Fault History",
            "Delete all fault history entries permanently?",
            QMessageBox.Yes | QMessageBox.No, QMessageBox.No)
        if reply == QMessageBox.Yes:
            try:
                with open(fault_file, "w") as f:
                    json.dump([], f)
                tbl.setRowCount(0)
            except Exception:
                pass



# ══════════════════════════════════════════════════════════════════════════════
#  FAULT PATTERN DATABASE DIALOG
# ══════════════════════════════════════════════════════════════════════════════
class FaultPatternDialog(QDialog):
    """
    Scans ALL ISC_*.csv log files in the logs directory and builds a
    cross-session fault frequency table: which DEM codes appear, how often,
    in how many sessions, and for how long total.
    """
    LOGS_DIR = rtt.USER_DIR.parent / "logs"   # C:\\Users\\<user>\\Documents\\ISCmetrics\\logs

    DEM_NAMES = {
        0:'No Fault', 1:'Lost Msg Setpoint', 2:'DCBus Undervoltage', 3:'PwrStg Overtemp',
        4:'PwrStg Temp Degrade', 5:'EMCtrl Fault', 6:'Task Overrun', 7:'CAN1 BusOff',
        8:'EMachine Overtemp', 9:'Phase Current OOR', 10:'PwrStg Temp OOR', 11:'DC Bus OOR',
        12:'DP Overtemp', 13:'DRV Overtemp', 14:'Aux Supply UV', 15:'Aux Supply OV',
        16:'Overspeed', 17:'Speed Degrade', 18:'EMachine Temp Degrade', 19:'Bad Current Offset',
        20:'AbsEnc Error 1', 21:'Ext Temp 1 OOR', 22:'Ext Temp 2 OOR (KTY)',
        23:'PMIC Not Ready', 26:'Invalid Calibration', 29:'Crosscheck Fault',
        32:'HW Supervisor Fault', 33:'KL30 UV', 34:'KL30 OV', 37:'LV Sensor Supply Fault',
    }

    def __init__(self, parent=None):
        super().__init__(parent)
        self.setWindowTitle("ISCmetrics - Fault Pattern Database")
        self.setWindowFlags(self.windowFlags() & ~Qt.WindowContextHelpButtonHint)
        self.setGeometry(150, 100, 950, 580)
        self.setStyleSheet(f"background:{F1_DARK_BG}; color:{F1_TEXT};")
        self._build()

    def _build(self):
        v = QVBoxLayout(self)
        v.setContentsMargins(14, 14, 14, 14)

        hdr_row = QHBoxLayout()
        title = QLabel("Cross-Session Fault Pattern Analysis")
        title.setStyleSheet(f"color:{ISC_GREEN}; font-size:13px; font-weight:bold;")
        hdr_row.addWidget(title)
        hdr_row.addStretch()
        self._lbl_scanned = QLabel("Scanning logs…")
        self._lbl_scanned.setStyleSheet("color:#666; font-size:10px;")
        hdr_row.addWidget(self._lbl_scanned)
        v.addLayout(hdr_row)

        # Main fault frequency table
        cols = ["DEM Code", "Fault Name", "Sessions", "Total Rows", "Est. Duration", "First Seen", "Last Seen"]
        self._tbl = QTableWidget(0, len(cols))
        self._tbl.setHorizontalHeaderLabels(cols)
        self._tbl.setEditTriggers(QTableWidget.NoEditTriggers)
        self._tbl.setSelectionBehavior(QTableWidget.SelectRows)
        self._tbl.horizontalHeader().setStretchLastSection(True)
        self._tbl.setStyleSheet(f"""
            QTableWidget {{ background:{F1_MID_BG}; color:{F1_TEXT};
                            gridline-color:#333; border:none; font-size:10px; }}
            QHeaderView::section {{ background:{F1_PANEL_BG}; color:{ISC_GREEN};
                                    font-size:10px; font-weight:bold; border:none; padding:4px; }}
            QTableWidget::item:selected {{ background:{ISC_GREEN}; color:{F1_DARK_BG}; }}
        """)
        v.addWidget(self._tbl)

        # Session detail sub-table
        detail_lbl = QLabel("Session breakdown (click a fault row above)")
        detail_lbl.setStyleSheet("color:#888; font-size:10px; margin-top:6px;")
        v.addWidget(detail_lbl)
        dcols = ["Session File", "Rows with Fault", "Est. Duration", "First at (s)", "Last at (s)"]
        self._dtbl = QTableWidget(0, len(dcols))
        self._dtbl.setHorizontalHeaderLabels(dcols)
        self._dtbl.setEditTriggers(QTableWidget.NoEditTriggers)
        self._dtbl.horizontalHeader().setStretchLastSection(True)
        self._dtbl.setMaximumHeight(160)
        self._dtbl.setStyleSheet(self._tbl.styleSheet())
        v.addWidget(self._dtbl)

        btn_row = QHBoxLayout()
        btn_refresh = QPushButton("Rescan Logs")
        btn_refresh.setStyleSheet(
            f"QPushButton{{background:{ISC_GREEN};color:{F1_DARK_BG};border:none;border-radius:3px;"
            f"padding:5px 14px;font-weight:bold;font-size:10px;}}QPushButton:hover{{background:#00a000;}}")
        btn_refresh.clicked.connect(self._scan)
        btn_row.addWidget(btn_refresh)
        btn_row.addStretch()
        btn_close = QPushButton("Close")
        btn_close.setStyleSheet(
            f"QPushButton{{background:{F1_PANEL_BG};color:{F1_TEXT};border:1px solid #444;"
            f"border-radius:3px;padding:5px 14px;font-size:10px;}}QPushButton:hover{{border-color:{ISC_GREEN};}}")
        btn_close.clicked.connect(self.accept)
        btn_row.addWidget(btn_close)
        v.addLayout(btn_row)

        self._tbl.cellClicked.connect(self._on_row_click)
        self._fault_data = {}  # dem_code -> {sessions: [...], total_rows, first_seen, last_seen}
        self._scan()

    def _scan(self):
        import csv as _csv
        from PyQt5.QtGui import QColor

        logs_dir = self.LOGS_DIR
        self._fault_data = {}   # dem_code -> {sessions:[{file,rows,dur_s,first_t,last_t}], total_rows, first_seen, last_seen}
        n_scanned = 0

        if logs_dir.exists():
            for path in sorted(logs_dir.glob("ISC_*.csv")):
                try:
                    with open(path, newline='', encoding='utf-8-sig') as f:
                        rd = _csv.DictReader(f)
                        if 'dem_code' not in (rd.fieldnames or []):
                            continue
                        rows_by_code: dict = {}
                        for row in rd:
                            try: code = int(row.get('dem_code', 0) or 0)
                            except: code = 0
                            if code == 0:
                                continue
                            try: t = float(row.get('time_elapsed_s', 0) or 0)
                            except: t = 0.0
                            rows_by_code.setdefault(code, []).append(t)

                    fname = path.name
                    for code, times in rows_by_code.items():
                        # Estimate duration: count × avg sample interval (assume 100ms)
                        est_dur_s = len(times) * 0.1
                        first_t = min(times)
                        last_t  = max(times)
                        entry = self._fault_data.setdefault(code, {
                            'sessions': [], 'total_rows': 0,
                            'first_seen': fname, 'last_seen': fname,
                        })
                        entry['sessions'].append({
                            'file': fname, 'rows': len(times),
                            'dur_s': est_dur_s, 'first_t': first_t, 'last_t': last_t,
                        })
                        entry['total_rows'] += len(times)
                        entry['last_seen'] = fname
                    n_scanned += 1
                except Exception:
                    continue

        self._lbl_scanned.setText(f"Scanned {n_scanned} log files from {logs_dir}")

        # Sort by total_rows descending (most common faults first)
        sorted_codes = sorted(self._fault_data.keys(),
                              key=lambda c: self._fault_data[c]['total_rows'], reverse=True)

        self._tbl.setRowCount(len(sorted_codes))
        for row_i, code in enumerate(sorted_codes):
            d = self._fault_data[code]
            n_sess = len(d['sessions'])
            total_dur = sum(s['dur_s'] for s in d['sessions'])
            dur_str = f"{total_dur:.0f}s" if total_dur < 120 else f"{total_dur/60:.1f}min"
            vals = [
                str(code),
                self.DEM_NAMES.get(code, f"Unknown ({code})"),
                str(n_sess),
                str(d['total_rows']),
                dur_str,
                d['first_seen'],
                d['last_seen'],
            ]
            for col, val in enumerate(vals):
                item = QTableWidgetItem(val)
                if code in (5, 10, 11, 29, 32):    # critical faults
                    item.setForeground(QColor(F1_ERROR))
                elif code in (16, 22, 3, 8):        # warning faults
                    item.setForeground(QColor(F1_WARNING))
                self._tbl.setItem(row_i, col, item)
        self._tbl.resizeColumnsToContents()
        self._sorted_codes = sorted_codes

        if not sorted_codes:
            self._tbl.setRowCount(1)
            self._tbl.setItem(0, 0, QTableWidgetItem("No faults found in scanned logs."))

    def _on_row_click(self, row, _col):
        if not hasattr(self, '_sorted_codes') or row >= len(self._sorted_codes):
            return
        code = self._sorted_codes[row]
        sessions = self._fault_data[code]['sessions']
        self._dtbl.setRowCount(len(sessions))
        for r, s in enumerate(sessions):
            dur_str = f"{s['dur_s']:.1f}s"
            for c, val in enumerate([
                s['file'], str(s['rows']), dur_str,
                f"{s['first_t']:.1f}", f"{s['last_t']:.1f}"
            ]):
                self._dtbl.setItem(r, c, QTableWidgetItem(val))
        self._dtbl.resizeColumnsToContents()


# ══════════════════════════════════════════════════════════════════════════════
#  BRAKE & APPS CALIBRATION WIZARD
# ══════════════════════════════════════════════════════════════════════════════
class BrakeCalibrationWizard(QDialog):

    """
    3-step guided wizard to calibrate APPS1, APPS2 and Brake ADC ranges.
    Hardcoded defaults remain the fallback if the wizard is never run.
    Wizard result is saved to settings.json via MainWindow._apply_pedal_calibration().
    """
    SAMPLE_MS  = 3000
    TICK_MS    = 100

    STEPS = [
        ("Step 1/3 - Release All Pedals",
         "Fully release BOTH pedals and hold them at rest.\n"
         "Click 'Start Sampling' - the wizard records resting ADC values for 3 seconds."),
        ("Step 2/3 - Press Throttle to the Floor",
         "Keep the brake released. Press the throttle pedal fully to the floor and hold.\n"
         "Click 'Start Sampling' to record APPS1 and APPS2 maximum values."),
        ("Step 3/3 - Press Brake to the Floor",
         "Release the throttle. Press the brake pedal fully to the floor and hold.\n"
         "Click 'Start Sampling' to record the brake maximum ADC value."),
        ("Calibration Complete - Review & Save",
         "These values will replace the hardcoded defaults.\n"
         "Click 'Save & Apply' to use them, or Cancel to discard."),
    ]

    def __init__(self, parent=None):
        super().__init__(parent)
        self.setWindowTitle("ISCmetrics - Pedal Calibration Wizard")
        self.setWindowFlags(self.windowFlags() & ~Qt.WindowContextHelpButtonHint)
        self.setGeometry(250, 200, 500, 380)
        self.setStyleSheet(f"background:{F1_DARK_BG}; color:{F1_TEXT};")
        self.result_cal: dict = {}
        self._step    = 0
        self._samples: list  = []
        self._elapsed = 0
        self._timer   = QTimer(self)
        self._timer.timeout.connect(self._on_tick)
        self._build()

    def _build(self):
        v = QVBoxLayout(self)
        v.setContentsMargins(20, 16, 20, 16)
        v.setSpacing(10)

        self._lbl_title = QLabel()
        self._lbl_title.setStyleSheet(f"color:{ISC_GREEN}; font-size:13px; font-weight:bold;")
        v.addWidget(self._lbl_title)

        self._lbl_instr = QLabel()
        self._lbl_instr.setWordWrap(True)
        self._lbl_instr.setStyleSheet(f"color:{F1_TEXT}; font-size:11px;")
        v.addWidget(self._lbl_instr)

        # Live ADC row
        adc_row = QHBoxLayout()
        for lbl_txt, attr in [("APPS1:", "_a1"), ("APPS2:", "_a2"), ("Brake:", "_brk")]:
            adc_row.addWidget(QLabel(lbl_txt))
            w = QLabel("---")
            w.setStyleSheet(f"color:{F1_WARNING}; font-weight:bold; font-size:12px; min-width:55px;")
            setattr(self, attr, w)
            adc_row.addWidget(w)
            adc_row.addSpacing(10)
        v.addLayout(adc_row)

        self._prog = QProgressBar()
        self._prog.setRange(0, self.SAMPLE_MS)
        self._prog.setValue(0)
        self._prog.setTextVisible(False)
        self._prog.setStyleSheet(
            f"QProgressBar{{background:{F1_MID_BG};border:1px solid #333;border-radius:3px;height:8px;}}"
            f"QProgressBar::chunk{{background:{ISC_GREEN};border-radius:3px;}}")
        self._prog.hide()
        v.addWidget(self._prog)

        self._lbl_status = QLabel("")
        self._lbl_status.setStyleSheet("color:#888; font-size:10px;")
        v.addWidget(self._lbl_status)

        self._lbl_result = QLabel("")
        self._lbl_result.setStyleSheet(f"color:{ISC_GREEN}; font-size:10px; font-family:'Courier New';")
        self._lbl_result.hide()
        v.addWidget(self._lbl_result)

        v.addStretch()

        btn_row = QHBoxLayout()
        self._btn_next = QPushButton("Start Sampling")
        self._btn_next.setStyleSheet(
            f"QPushButton{{background:{ISC_GREEN};color:{F1_DARK_BG};border:none;border-radius:3px;"
            f"padding:7px 18px;font-weight:bold;}}QPushButton:hover{{background:#00a000;}}")
        self._btn_next.clicked.connect(self._on_next)
        btn_row.addWidget(self._btn_next)

        btn_cancel = QPushButton("Cancel")
        btn_cancel.setStyleSheet(
            f"QPushButton{{background:{F1_PANEL_BG};color:{F1_TEXT};border:1px solid #444;"
            f"border-radius:3px;padding:7px 14px;}}QPushButton:hover{{border-color:{F1_ERROR};}}")
        btn_cancel.clicked.connect(self.reject)
        btn_row.addWidget(btn_cancel)
        v.addLayout(btn_row)

        # Live poll
        self._live = QTimer(self)
        self._live.timeout.connect(self._update_adc)
        self._live.start(150)

        self._refresh_step()

    def _refresh_step(self):
        title, instr = self.STEPS[min(self._step, len(self.STEPS)-1)]
        self._lbl_title.setText(title)
        self._lbl_instr.setText(instr)
        self._btn_next.setText("Start Sampling" if self._step < 3 else "Save & Apply")

    def _update_adc(self):
        d = rtt.get_latest_data()
        # Try snapshot sub-key first, then flat top-level (both formats used across versions)
        s = d.get('snapshot') or d
        a1  = s.get('apps1_raw')
        a2  = s.get('apps2_raw')
        brk = s.get('brake_raw')
        if a1 is not None:
            self._a1.setText(str(a1))
            self._a2.setText(str(a2))
            self._brk.setText(str(brk))
            self._lbl_status.setText("🟢 Live data from car")
        else:
            self._a1.setText("---")
            self._a2.setText("---")
            self._brk.setText("---")
            self._lbl_status.setText("⚠ Waiting for car data…")

    def _on_next(self):
        if self._step == 3:
            self._live.stop()
            self.accept()
            return
        self._samples = []
        self._elapsed = 0
        self._prog.setValue(0)
        self._prog.show()
        self._btn_next.setEnabled(False)
        self._lbl_status.setText("Sampling...")
        self._timer.start(self.TICK_MS)

    def _on_tick(self):
        s = rtt.get_latest_data().get('snapshot', {})
        a1  = s.get('apps1_raw')
        a2  = s.get('apps2_raw')
        brk = s.get('brake_raw')
        if None not in (a1, a2, brk):
            self._samples.append((int(a1), int(a2), int(brk)))
        self._elapsed += self.TICK_MS
        self._prog.setValue(self._elapsed)
        if self._elapsed >= self.SAMPLE_MS:
            self._timer.stop()
            self._process_step()

    def _process_step(self):
        if not self._samples:
            self._lbl_status.setText("No data - is the car on?")
            self._btn_next.setEnabled(True)
            return
        a1s  = [x[0] for x in self._samples]
        a2s  = [x[1] for x in self._samples]
        brks = [x[2] for x in self._samples]
        avg  = lambda lst: int(sum(lst) / len(lst))

        if self._step == 0:
            self.result_cal.update({'apps1_min': avg(a1s), 'apps2_min': avg(a2s), 'brk_min': avg(brks)})
            self._lbl_status.setText(
                f"Resting: APPS1_MIN={self.result_cal['apps1_min']}  "
                f"APPS2_MIN={self.result_cal['apps2_min']}  BRK_MIN={self.result_cal['brk_min']}")
        elif self._step == 1:
            self.result_cal.update({'apps1_max': avg(a1s), 'apps2_max': avg(a2s)})
            self._lbl_status.setText(
                f"WOT: APPS1_MAX={self.result_cal['apps1_max']}  APPS2_MAX={self.result_cal['apps2_max']}")
        elif self._step == 2:
            self.result_cal['brk_max'] = avg(brks)
            self._lbl_status.setText(f"Full brake: BRK_MAX={self.result_cal['brk_max']}")

        self._step += 1
        self._prog.hide()
        self._btn_next.setEnabled(True)
        self._refresh_step()

        if self._step == 3:
            c = self.result_cal
            self._lbl_result.setText(
                f"APPS1:  {c.get('apps1_min','?')} -> {c.get('apps1_max','?')}\n"
                f"APPS2:  {c.get('apps2_min','?')} -> {c.get('apps2_max','?')}\n"
                f"Brake:  {c.get('brk_min','?')} -> {c.get('brk_max','?')}")
            self._lbl_result.show()

    def closeEvent(self, ev):
        self._timer.stop()
        self._live.stop()
        super().closeEvent(ev)


# ── Remaining SettingsDialog methods (restored to correct class scope) ─────────
# These must live inside SettingsDialog, not BrakeCalibrationWizard.
# We re-open SettingsDialog here using monkey-patching to avoid a full rewrite.
def _sd_open_cal_wizard(self):
    """Launch the BrakeCalibrationWizard with live telemetry feed; apply results immediately."""
    main = self._p
    port = main.settings.get("port")
    baud = int(main.settings.get("baud", 115200))

    # If not already receiving, start a temporary live session for calibration
    _started_for_cal = False
    if not main.is_receiving and port:
        import threading
        rtt.new_data_flag = 0
        bucket = rtt.create_bucket("CAL_WIZ", "calibration")
        def _cal_worker():
            try:
                rtt.receive_data(bucket_id=bucket, piloto="CAL_WIZ", circuito="calibration",
                                 port=port, baud=baud, use_influx=False, debug=False)
            except Exception:
                pass
            finally:
                main.is_receiving = False
        main.rx_thread = threading.Thread(target=_cal_worker, daemon=True)
        main.rx_thread.start()
        main.is_receiving = True
        _started_for_cal = True
    elif not port:
        from PyQt5.QtWidgets import QMessageBox
        QMessageBox.warning(self, "No COM Port",
            "No COM port is selected.\n"
            "Select a port in Settings and try again, or start reception first.")
        return

    wiz = BrakeCalibrationWizard(self._p)
    result = wiz.exec_()

    # Stop the temporary session if we started it just for calibration
    if _started_for_cal:
        rtt.new_data_flag = -1
        if main.rx_thread and main.rx_thread.is_alive():
            main.rx_thread.join(timeout=1.5)
        main.is_receiving = False

    if result:
        main._apply_pedal_calibration(wiz.result_cal)


def _sd_on_marple_toggled(self, state: int):
    """Ask for the Marple API password whenever the checkbox is ticked on."""
    if state == 0:
        return  # unchecking — always allowed
    pwd, ok = QInputDialog.getText(
        self,
        "Marple Upload — Authentication Required",
        "Enter the Marple API password:",
        QLineEdit.Password,
    )
    if not ok:
        self.chk_marple.blockSignals(True)
        self.chk_marple.setChecked(False)
        self.chk_marple.blockSignals(False)
        return
    entered_hash = hashlib.sha256(pwd.encode()).hexdigest()
    if entered_hash != _MARPLE_PASSWORD_HASH:
        QMessageBox.warning(
            self,
            "Access Denied",
            "Incorrect password.\nMarple cloud upload has not been enabled.",
        )
        self.chk_marple.blockSignals(True)
        self.chk_marple.setChecked(False)
        self.chk_marple.blockSignals(False)

@staticmethod
def _sd_lbl(t, s):
    l = QLabel(t); l.setStyleSheet(s); return l

def _sd_refresh_ports(self):
    self.combo_port.clear()
    cur = self._p.settings.get("port")
    for i, (port, desc) in enumerate(rtt.list_serial_ports()):
        self.combo_port.addItem(f"{port}  ({desc})", port)
        if port == cur:
            self.combo_port.setCurrentIndex(i)

def _sd_get_settings(self) -> dict:
    try:    baud = int(self.input_baud.text())
    except: baud = self._p.settings["baud"]
    try:    temp_c = float(self.input_alert_temp.text())
    except: temp_c = self._p.settings.get("alert_temp_c", 40.0)
    try:    volt_v = float(self.input_alert_volt.text())
    except: volt_v = self._p.settings.get("alert_volt_v", 380.0)
    try:    cell_mv = float(self.input_alert_cell.text())
    except: cell_mv = self._p.settings.get("alert_cell_mv", 3400.0)
    try:    cell_imb_mv = float(self.input_alert_imb.text())
    except: cell_imb_mv = self._p.settings.get("alert_cell_imb_mv", 100.0)
    return {
        "port":             self.combo_port.currentData(),
        "baud":             baud,
        "use_influx":       self.chk_marple.isChecked(),
        "debug":            self.chk_debug.isChecked(),
        "demo_mode":        self.chk_demo.isChecked(),
        "enable_tts":       self.chk_tts.isChecked(),
        "alert_temp_c":     temp_c,
        "alert_volt_v":     volt_v,
        "alert_cell_mv":    cell_mv,
        "alert_cell_imb_mv": cell_imb_mv,
    }

# Bind the orphaned methods back onto SettingsDialog
SettingsDialog._open_cal_wizard  = _sd_open_cal_wizard
SettingsDialog._on_marple_toggled= _sd_on_marple_toggled
SettingsDialog._lbl              = staticmethod(_sd_lbl.__func__ if hasattr(_sd_lbl, '__func__') else _sd_lbl)
SettingsDialog._refresh_ports    = _sd_refresh_ports
SettingsDialog.get_settings      = _sd_get_settings


# ══════════════════════════════════════════════════════════════════════════════
#  SESSION VIEWER
# ══════════════════════════════════════════════════════════════════════════════
class SessionViewerWindow(QWidget):
    def __init__(self):
        super().__init__()
        self.setWindowTitle("ISCmetrics — Session Viewer")
        self.setGeometry(160, 160, 1100, 650)
        self.setStyleSheet(f"background:{F1_DARK_BG}; color:{F1_TEXT};")
        self._build()

    def _build(self):
        h = QHBoxLayout(self)
        # Sidebar
        side = QVBoxLayout()
        hdr = QLabel("Saved Sessions")
        hdr.setStyleSheet(f"color:{ISC_GREEN}; font-weight:bold; font-size:12px;")
        side.addWidget(hdr)
        self._list = QListWidget()
        self._list.setStyleSheet(f"background:{F1_PANEL_BG}; color:{F1_TEXT}; border:1px solid #333;")
        self._list.itemDoubleClicked.connect(self._load)
        side.addWidget(self._list)
        btn = QPushButton("Refresh")
        btn.setStyleSheet(f"background:{F1_MID_BG}; color:{ISC_GREEN}; border:1px solid {ISC_GREEN}; padding:4px 8px;")
        btn.clicked.connect(self._refresh)
        side.addWidget(btn)

        btn_marple = QPushButton("🚀 Export to Marple")
        btn_marple.setStyleSheet(f"background:{ISC_GREEN}; color:{F1_DARK_BG}; font-weight:bold; border:none; padding:5px 8px; border-radius:2px; font-size:10px;")
        btn_marple.setToolTip("Upload the selected session file directly to Marple Data")
        btn_marple.clicked.connect(self._export_to_marple)
        side.addWidget(btn_marple)

        sw = QWidget(); sw.setLayout(side); sw.setFixedWidth(240)
        h.addWidget(sw)

        # Content
        right = QVBoxLayout()
        header_row = QHBoxLayout()
        self._info = QLabel("Double-click a session to load.")
        self._info.setStyleSheet("color:#555; padding:8px;")
        header_row.addWidget(self._info, stretch=1)

        self._btn_export_curr = QPushButton("🚀 Export to Marple")
        self._btn_export_curr.setStyleSheet(f"background:{F1_PANEL_BG}; color:{ISC_GREEN}; border:1px solid {ISC_GREEN}; padding:4px 10px; font-weight:bold; border-radius:2px; font-size:10px;")
        self._btn_export_curr.setEnabled(False)
        self._btn_export_curr.clicked.connect(self._export_to_marple)
        header_row.addWidget(self._btn_export_curr)

        right.addLayout(header_row)
        self._txt = QTextEdit()
        self._txt.setReadOnly(True)
        self._txt.setStyleSheet(
            f"background:{F1_PANEL_BG}; color:{F1_TEXT}; font-family:'Courier New'; font-size:9px;")
        right.addWidget(self._txt)
        rw = QWidget(); rw.setLayout(right)
        h.addWidget(rw)
        self._loaded_path = None
        self._refresh()

    def _refresh(self):
        self._list.clear()
        for f in rtt.list_excel_sessions():
            item = QListWidgetItem(f.name)
            item.setData(Qt.UserRole, str(f))
            self._list.addItem(item)

    def _load(self, item: QListWidgetItem):
        path = Path(item.data(Qt.UserRole))
        self._loaded_path = path
        data = rtt.load_excel_session(path)
        if 'Main' in data:
            df = data['Main']
            self._info.setText(f"{path.name} — {len(df)} rows × {len(df.columns)} cols")
            self._txt.setPlainText(df.to_string(max_rows=60))
            self._btn_export_curr.setEnabled(True)
        else:
            self._info.setText("Failed to load.")
            self._btn_export_curr.setEnabled(False)

    def _export_to_marple(self):
        path = None
        if self._loaded_path and self._loaded_path.exists():
            path = self._loaded_path
        else:
            curr = self._list.currentItem()
            if curr:
                p = Path(curr.data(Qt.UserRole))
                if p.exists():
                    path = p

        if not path:
            QMessageBox.information(self, "Export to Marple", "Please select a session from the list to export.")
            return

        if CORE_MODULES_OK:
            dlg = ManualMarpleExportDialog(path, parent=self)
            dlg.exec_()
        else:
            QMessageBox.warning(self, "Module Missing", "Marple exporter module is not loaded.")
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
