isc-fs/IFS09-TE/(commit log)

2026-09-07 feat(telemetry): migrate real-time software (isc_realtime_26), firmware, and hardware for IFS09
    [IFS09-TeleReceiver.kicad_pcb, IFS09-TeleReceiver.kicad_sch, extracted_LOG0001.CSV]
2026-09-19 feat(ui): ISCmetrics v2.3.0 — fix settings layout, live pedal calibration, and solid button fill
    [ui.py]
2026-09-19 fix(version): correct APP_VERSION to 2.9.0 for IFS09 release
    [ui.py]
2026-09-21 feat(telem): add Full ACU Overview dashboard, 0x4A3/0x4B0/0x4B1 CAN unpacking, torque telemetry, and Marple export mapping
2026-09-21 feat(ui): optimize rendering performance, input latency, and visual readability
    - Enhance typography, contrast, and layout across all telemetry tabs (Segoe UI 10pt/Consolas, high contrast palette, enhanced borders and padding)
    - Implement tab-gated rendering in MainWindow._update to avoid redrawing inactive tabs
    - Add cell diffing and cache for 95 voltage and 190 temperature cells in Full ACU Overview tab
    - Remove slow python text cursor truncation loop from _log_append in favor of native setMaximumBlockCount(200)
    - Add diff guards and visibility checks to MetricCard, MplCanvas, and custom QPainter widgets
    - Overhaul input styles and sizing for responsive, lag-free text entry in pilot, circu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
    [ui.py]
2026-09-21 fix(ui): revert ISC_GREEN to #008000 and fix QFont float type error in paintEvent
    - Revert primary accent ISC_GREEN from #00c853 back to official #008000
    - Fix TypeError in QFont instantiation across PedalWidget, GCircleWidget, and ModuleBarWidget by using integer point sizes (9 and 10) instead of floats (8.5 and 9.5)
    - Validate error-free repainting across all 6 tabs
    [ui.py]
2026-10-01 Add multi-log sync and Marple export UI
    Introduces new `core` and `ui` packages with a synchronization engine (`MultiLogSynchronizer`) and asynchronous Marple export client/worker, plus new post-merge/export dialogs. The Post-Race and Session Viewer UIs now support IMU/AMS/GPS multi-log workflows and direct Marple uploads, while the demo generator gains real-log replay mode and safer AMS merge handling. Also hardens AMS merge numeric alignment in `ISC_RTT_serial.py`, updates PyInstaller hidden imports, and adds test coverage for sync/export/demo regression paths.
2026-10-06 feat(ui): replace ACU overview with Inverter Diagnostics and FS 80kW power monitor
    [ISC_RTT_demo.py, ISC_RTT_serial.py, isc_marple.py, ui.py]
